mash/cupwarmer/wiki/source-celus-ai-electronics-design.md

---
title: CELUS AI 設計要約
type: source-summary
tags: [celus, ai, schematic, component-search]
sources: [celus-ai-electronics-design.md]
created: 2026-04-11
updated: 2026-04-11
---

[CELUS AI Electronics Design](raw/celus-ai-electronics-design.md) は、CELUS の価値が component search と schematic generation の自動化にあることを示している。

最終 PCB の主戦場というより、前工程を速めて EDA へ handoff する補助ツールとして理解するのが自然である。
