mash/cupwarmer/wiki/source-flux-ai-pcb-design.md

---
title: Flux AI PCB 要約
type: source-summary
tags: [flux, ai, pcb, schematic]
sources: [flux-ai-pcb-design.md]
created: 2026-04-11
updated: 2026-04-11
---

[Flux AI PCB Design](raw/flux-ai-pcb-design.md) は、Flux が AI を設計体験の中心に据えていることを示している。要件整理、部品選定、BOM、回路図変更、datasheet parsing まで AI が直接支援する。

ただし公式ドキュメント自身が、AI は `schematics` 主体で、`PCB layout and trace positioning` の理解は `limited` と述べている。したがって、AI の強さと高密度レイアウトの強さは同義ではない。
