mash/cupwarmer/wiki/source-kicad-pcb-design-features.md

---
title: KiCad PCB 機能要約
type: source-summary
tags: [kicad, pcb, rules, plugins, open-source]
sources: [kicad-pcb-design-features.md, kicad-plugin-and-rules.md]
created: 2026-04-11
updated: 2026-04-11
---

[KiCad PCB Design Features](raw/kicad-pcb-design-features.md) と [KiCad Plugins and Rules](raw/kicad-plugin-and-rules.md) から、KiCad は AI 内蔵 EDA ではないが、`interactive router`、`custom design rules`、`Plugin and Content Manager`、`Action plugins`、`up to 32 copper layers` を持つことが分かる。

つまり KiCad の強みは「生成AIが賢いこと」ではなく、「設計者がルールを握ったまま、拡張しやすい安定した PCB 基盤」である。
