mash/cupwarmer/wiki/source-wpc-qi-specification.md

---
title: WPC Qi Specification 要約
type: source-summary
tags: [qi, wpc, spec, versions]
sources: [wpc-qi-specification.md]
created: 2026-04-11
updated: 2026-04-11
---

[WPC Qi Specification 原文](raw/wpc-qi-specification.md) は、`Qi` 仕様の版の流れを確認するのに有用である。`v1.0` から `v2.0` までの履歴が明記され、2026-04-11 時点の最新仕様は `v2.3` とされている。

この履歴により、`Qi` の版差分を `BPP` 世代の旧設計から `EPP` や `Qi2` まで連続した流れとして把握できる。現行の `15W` 検討では、版名だけでなく対応プロファイルと認証状況も合わせて見る必要がある。

版差分を前提にした実務整理は [Qi Wireless Power](qi-wireless-power.md) にまとめた。
