mash/cupwarmer/wiki/raw/altium-designer-and-ai.md

# Altium Designer and AI Notes

- Source 1: [Altium Designer](https://www.altium.com/altium-designer)
- Source 2: [Altium AI & Machine Learning resources](https://resources.altium.com/ai-design)
- Accessed: 2026-04-11

## Notes

- Altium Designer は `schematics and layout to simulation and analysis` を統合した商用 EDA。
- `Smart Interactive Routing`、`Assistive Layout Technology`、`HDI Design`、`constraint management` を明示している。
- Altium の AI ページは、`built-in machine learning to increase productivity with design flows` と述べるが、Flux のような明確な AI copilot 製品説明ではない。

## Relevance

- AI よりも、HDI / dense layout / 商用ワークフローの強さが本質。
- 予算が許せば `WLCSP` や高密度案件との相性は強い。
