mash/cupwarmer/wiki/raw/celus-ai-electronics-design.md

# CELUS AI Electronics Design

- Source: [CELUS Design Platform for Engineers](https://www.celus.io/solutions/engineers)
- Accessed: 2026-04-11

## Notes

- CELUS は `AI-driven automation` により component search と schematic generation を自動化すると説明している。
- `automates component search and schematic generation` が中心メッセージ。
- `handover to EDA files` を案内しており、自前で最終 PCB を全部抱えるというより前工程自動化寄り。

## Relevance

- 回路の初期案作成には向く。
- 最終 PCB を詰める主戦場というより、前工程を短縮する補助ツールとして見るのが自然。
