mash/cupwarmer/wiki/raw/flux-ai-pcb-design.md

# Flux AI PCB Design

- Source 1: [Flux home](https://www.flux.ai/)
- Source 2: [Flux AI assistant docs](https://www.flux.ai/COPILOT)
- Accessed: 2026-04-11

## Notes

- Flux は `Design PCBs with AI` を掲げるブラウザベース EDA。
- AI は要件整理、部品選定、BOM、回路図生成、設計変更支援を行う。
- ドキュメントでは AI が `schematics` を主に扱い、`PCB layout and trace positioning` の理解は `limited` と明記している。
- AI は datasheet parsing、component search、design feedback、schematic modifications を行える。

## Relevance

- AI 支援の強さは明確。
- ただし今回のような `WLCSP40`、`FOD`、外注 DFM 前提の細かいレイアウト案件では、AI の強みが回路図寄りに偏る。
