mash/cupwarmer/wiki/raw/kicad-pcb-design-features.md

# KiCad PCB Design Features

- Source: [KiCad PCB Design in PcbNew](https://www.kicad.org/discover/pcb-design/)
- Accessed: 2026-04-11

## Notes

- KiCad は回路図と PCB の統合フローを持つ。
- `interactive router` を持つ。
- `DRC with scripting support` を持つ。
- 他 CAD からの import も案内している。
- `length tuning`、`Footprint Editor`、`3D Viewer` がある。

## Relevance

- AI 内蔵 EDA ではないが、個人開発に必要な PCB 基盤機能は十分強い。
- `WLCSP` のような難物でも、ルールを明示して運用する土台として使える。
