mash/cupwarmer/wiki/raw/wpc-qi-specification.md

# WPC Qi Specification Overview

- Source: [Qi Specification (Wireless Power Consortium)](https://www.wirelesspowerconsortium.com/knowledge-base/qi-specification/)
- Accessed: 2026-04-11

## Notes

- WPC は `Qi` 仕様の履歴として、`v1.0` が 2010 年、`v1.1` が 2012 年、`v1.2` が 2015 年、`v1.3` が 2021 年、`v2.0` が 2023 年と示している。
- 最新仕様は `v2.3` と記載されているが、詳細本文のダウンロードは会員向け。
- 自動車向けガイドラインなど派生の設計資料も管理されている。

## Relevance

- プロジェクトが使おうとしている `BQ51013B` の `Qi v1.2` 対応という表現を、仕様の歴史の中で位置づけられる。
