mash/cupwarmer/wiki/fod-foreign-object-detection.md

---
title: Foreign Object Detection
type: concept
tags: [qi, fod, safety, wireless-power, cup-warmer, magnets]
sources: [wpc-qi-v13-power-delivery.md, wpc-qi2-magnetic-alignment.md, infineon-wlc1115-15w-transmitter.md, nxp-mwpr1516-15w-wireless-charging-receiver.md]
created: 2026-04-11
updated: 2026-04-11
---

`FOD` は `Foreign Object Detection` の略で、`Qi` の送受電コイル間に想定外の金属物体などが入ったときに、余計な損失と発熱を検出して危険を抑えるための仕組みである。

## 何を防ぐのか

`Qi` では、受電器そのものではない金属片や構造材が磁界で加熱されうる。問題は「充電効率が落ちる」ことではなく、想定外の場所が熱くなることにある。

特に危険なのは次のようなケースである。

- コインやクリップなどの金属小物
- 金属底のカップやマグ
- コイル近傍の金属プレートやネジ
- 位置ずれや距離増加で損失が増えた構造

## どうやって成立するか

[Infineon WLC1115 要約](source-infineon-wlc1115-15w-transmitter.md) にある通り、現行の送電側は `Q-factor`、共振周波数、電力損失など複数の指標を見て `FOD` を実装する。これは、想定した受電条件から外れた損失が増えたときに、どこかで余計な発熱が起きているとみなす考え方である。

[NXP MWPR1516 要約](source-nxp-mwpr1516-15w-wireless-charging-receiver.md) のように、受電側も `FOD` アルゴリズムを持つものがある。したがって `FOD` は送電側だけの話ではなく、送受電系全体の損失挙動をどう扱うかという設計課題である。

## Cup Warmer で難しくなる理由

Cup Warmer は、`Qi` 本来のスマートフォン充電よりも `FOD` を難しくしやすい。

理由は、コイルの上に置くもの自体が熱設計対象であり、さらにヒーター、トッププレート、断熱材、フェライトなどの積層でコイル間距離と損失が増えやすいためである。[WPC Qi v1.3 Power Delivery 要約](source-wpc-qi-v13-power-delivery.md) が示すように、受電側はコイル、共振、シールドの構成に強く依存するので、積層変更は単なるメカ設計変更ではない。

Cup Warmer 文脈では、次が `FOD` 誤検出や停止の要因になりやすい。

- 金属カップ底面
- 金属トッププレート
- ヒーター材による追加損失
- コイル中心からの位置ずれ
- コイル間距離の増加
- フェライトやシールドの不足

## 非金属カップ前提なら何が残るか

金属カップを対象外にすると、`FOD` の難所は「ユーザーのカップ材質」より「自分で作る積層構造」に寄る。優先度が高いのは次である。

- 金属トッププレートや化粧層の混入
- ヒーター材による余計な損失
- コイル間距離の増加
- 送電パッドと受電コイルの位置ずれ
- フェライト不足や磁束漏れ
- 送電パッドごとの `FOD` 閾値差

逆に、金属カップ底が異物扱いされる問題は、この前提では主要課題から外せる。

## 設計上の含意

`FOD` は後付けの安全機能ではなく、送受電アーキテクチャの一部として扱うべきである。Cup Warmer では少なくとも次を早期に評価する必要がある。

- どの送電パッドで安定給電するか
- どの位置ずれ条件で停止するか
- 金属マグや金属部材がどこで異物扱いになるか
- 温度上昇と `FOD` 停止がどう対応するか

言い換えると、「発熱したか」だけでは不十分で、「安全に継続給電できる構造か」を見る必要がある。

## 非金属カップ前提の評価表

| 項目 | 何を見るか | 主な失敗モード | 優先度 |
|---|---|---|---|
| 受電コイル単体 | ベースライン給電の安定性 | そもそも規定電力に届かない | 高 |
| フェライト追加 | 効率と停止耐性の改善 | 磁束漏れで損失が大きい | 高 |
| ヒーター積層 | ヒーター材の追加損失 | `FOD` 停止、局所発熱 | 高 |
| トッププレート積層 | 表面材の影響 | 金属層で損失増、温度上昇 | 高 |
| 位置ずれ | 許容オフセット量 | 特定位置で停止、出力低下 | 高 |
| パッド差 | 送電側ごとの相性 | あるパッドだけ停止する | 中 |
| 長時間運転 | 温度と停止の再現性 | 徐々に加熱されて後から停止 | 中 |

## 位置ずれ対策として磁石は使えるか

使える。ただし「何を位置合わせしたいか」を分けて考える必要がある。

[WPC Qi2 Magnetic Alignment 要約](source-wpc-qi2-magnetic-alignment.md) が示す通り、`Qi2` は磁気位置合わせを公式に採用している。したがって、磁石を使うこと自体が `Qi` 系ワイヤレス給電と矛盾するわけではない。

一方で、このプロジェクトは現時点で `Qi2` 準拠品ではない。したがって磁石は「標準機能の利用」ではなく、独自の位置ずれ補助手段として評価すべきである。

実務上は、次の 2 つを分けるべきである。

- 送電パッドと受電コイルの中心合わせを補助する磁石
- カップそのものの置き位置を決めるための磁石

前者は `FOD` と効率の改善に効く可能性がある。後者は、陶器カップ前提なら直接は固定できず、磁性体追加や別部材が必要になるので設計上の見返りが小さい。

## 磁石を使う場合の注意点

- 磁石は受電コイルの中心合わせ補助として使う
- コイル直下や磁束経路を乱す位置に安易に置かない
- 磁石だけでなく、保持用の金属リングやヨーク材の影響も評価する
- `Qi2` の磁石配置をそのまま流用するのではなく、独自構造として停止条件を確認する
- 磁石追加後は、効率、位置ずれ耐性、温度上昇、`FOD` 停止条件を再測定する

## このプロジェクトでの実務的な読み替え

- `Qi` 受電部は単なる無線 `5V` 電源ではない
- 熱源、天板、固定部材の材質選定は `FOD` に直結する
- 金属カップ対応を目指すなら、かなり早い段階で実機評価が必要になる
- パッド互換性は出力ワット数だけでなく `FOD` の閾値差にも左右される

## 関連ページ

- [Qi Wireless Power](qi-wireless-power.md)
- [Qi 15W Receiver Options](qi-15w-receiver-options.md)
- [Infineon WLC1115 要約](source-infineon-wlc1115-15w-transmitter.md)
- [NXP MWPR1516 要約](source-nxp-mwpr1516-15w-wireless-charging-receiver.md)
- [WPC Qi2 Magnetic Alignment 要約](source-wpc-qi2-magnetic-alignment.md)
