mash/cupwarmer/wiki/source-littelfuse-polyswitch-resettable-pptc-devices.md

---
title: Littelfuse PolySwitch PPTC 要約
type: source-summary
tags: [pptc, ptc, fuse, protection, resettable]
sources: [littelfuse-polyswitch-resettable-pptc-devices.md]
created: 2026-04-11
updated: 2026-04-11
---

[Littelfuse PolySwitch 原文](raw/littelfuse-polyswitch-resettable-pptc-devices.md) は、`PPTC` を自動復帰型の過電流保護部品として整理している。温度上昇で抵抗が増え、異常電流を制限し、冷えると元に戻る。

この説明は、セラミック `PTC` 一般論よりも「保護デバイス」としての `PTC` を理解するのに向いている。通常のヒューズと違い交換不要で、反復的な故障やアクセスしにくい機器に向くという整理も重要。

Cup Warmer の `PTC ヒューズ` という表現は、厳密にはこの `PPTC` 系の考え方に近い。したがって [PTC Thermistor](ptc-thermistor.md) では、セラミック `PTC` とポリマー `PPTC` を分けて扱う必要がある。
