mash/cupwarmer/wiki/source-renesas-p9221-r-15w-wireless-power-receiver.md

---
title: Renesas P9221-R 要約
type: source-summary
tags: [qi, epp, 15w, receiver, renesas, obsolete]
sources: [renesas-p9221-r-15w-wireless-power-receiver.md]
created: 2026-04-11
updated: 2026-04-11
---

[Renesas P9221-R 原文](raw/renesas-p9221-r-15w-wireless-power-receiver.md) は、`15W` 受電器としては魅力的な仕様を持つ一方で、2026-04-11 時点では `Obsolete` であることを明確にしている。

そのため、このページは「技術的には参考になるが、新規設計の第一候補にはしにくい」という位置づけになる。

判断の落とし込みは [Qi 15W Receiver Options](qi-15w-receiver-options.md) にまとめた。
