mash/cupwarmer/wiki/source-renesas-p9415-r-evk-15w-rx-eval-board.md

---
title: Renesas P9415-R-EVK 要約
type: source-summary
tags: [qi, 15w, epp, receiver, eval-board, renesas, obsolete]
sources: [renesas-p9415-r-evk-15w-rx-eval-board.md]
created: 2026-04-11
updated: 2026-04-11
---

[Renesas P9415-R-EVK 原文](raw/renesas-p9415-r-evk-15w-rx-eval-board.md) は、`15W EPP` 受電の turnkey reference design としては充実しているが、2026-04-11 時点では `Obsolete` である。

そのため、設計学習や比較資料としては有効だが、新規製品の採用候補としては弱い。
