mash/cupwarmer/wiki/source-st-steval-isb042v1-15w-rx-eval-board.md

---
title: ST STEVAL-ISB042V1 要約
type: source-summary
tags: [qi, 15w, epp, receiver, eval-board, st]
sources: [st-steval-isb042v1-15w-rx-eval-board.md]
created: 2026-04-11
updated: 2026-04-11
---

[ST STEVAL-ISB042V1 原文](raw/st-steval-isb042v1-15w-rx-eval-board.md) は、`STWLC33` ベースで `15W EPP` と `5W BPP` の両方を扱える受電評価ボードを示している。`FOD` と `I2C` を持つ complete kit だが、2026-04-11 時点では `Out of Production` である。

したがって、量産本命ではなく「`15W` と `FOD` を先に触るための古い参照設計」として見るのが適切である。
