mash/cupwarmer/wiki/source-st-steval-wlc38rx-receiver-board-press-release.md

---
title: ST STEVAL-WLC38RX 要約
type: source-summary
tags: [qi, 15w, receiver, eval-board, st, stwlc38]
sources: [st-steval-wlc38rx-receiver-board-press-release.md]
created: 2026-04-11
updated: 2026-04-11
---

[ST STEVAL-WLC38RX 原文](raw/st-steval-wlc38rx-receiver-board-press-release.md) は、`STWLC38` ベースの `5W/15W` 受電評価ボードが、試作と試験を加速する目的で提供されていることを示す。Mouser 掲載の data brief ベースでは、`Qi 1.3`、`5W BPP` / `15W EPP`、`I2C` 設定、オンボード `USB-to-I2C bridge`、`STSW-WPSTUDIO` GUI、`ARC`、`FOD` 用の電圧 / 電流測定、on-chip thermal management まで確認できる。

Cup Warmer 文脈では、`WLCSP40` の直接実装を避けつつ、`15W` の熱・`FOD`・位置ずれ評価に入れる点が重要である。特に USB-I2C と GUI があるため、初期 bring-up と設定確認を IC 単体実装よりかなり楽に始められる。
