mash/cupwarmer/wiki/source-wpc-qi-certified-products.md

---
title: WPC Qi Certified Products 要約
type: source-summary
tags: [qi, certification, interoperability, safety]
sources: [wpc-qi-certified-products.md]
created: 2026-04-11
updated: 2026-04-11
---

[WPC Qi Certified Products 原文](raw/wpc-qi-certified-products.md) は、`Qi Certified` の意味を明確にしている。認証済み製品は独立試験で安全性、相互運用性、エネルギー効率を確認されている一方、`Qi compatible` のような表現は正式認証を示さない。

この点はプロトタイピングで重要で、市販パッドを使うときは「給電できたか」だけでなく「認証済みか」を分けて記録すべきだと分かる。

実務的な含意は [Qi Wireless Power](qi-wireless-power.md) と [Foreign Object Detection](fod-foreign-object-detection.md) に接続する。
