mash/cupwarmer/wiki/source-wpc-qi-wireless-charging.md

---
title: WPC Qi Wireless Charging 要約
type: source-summary
tags: [qi, wpc, certification, overview]
sources: [wpc-qi-wireless-charging.md]
created: 2026-04-11
updated: 2026-04-11
---

[WPC Qi Wireless Charging 原文](raw/wpc-qi-wireless-charging.md) は、`Qi` を携帯機器向けワイヤレス充電の中心標準として位置づけている。2026-04-11 時点では、2010 年開始、`13,000` 超の認証製品、`Qi2 25W` の登場までが概観できる。

このページの重要点は、`Qi` を単なる電力伝送方式ではなく、安全性と相互運用性を含む認証体系として扱っていることにある。よって「Qi 対応」と「Qi 認証」は同義ではない。

一般概念の整理は [Qi Wireless Power](qi-wireless-power.md) に反映した。
