mash/cupwarmer/wiki/source-wpc-qi2-magnetic-alignment.md

---
title: WPC Qi2 Magnetic Alignment 要約
type: source-summary
tags: [qi, qi2, magnets, alignment, wpc]
sources: [wpc-qi2-magnetic-alignment.md]
created: 2026-04-11
updated: 2026-04-11
---

[WPC Qi2 Magnetic Alignment 原文](raw/wpc-qi2-magnetic-alignment.md) は、`Qi2` が magnetic attachment technology を使って位置合わせと効率改善を図ることを示している。

このソースから分かるのは、磁石が `Qi` 系ワイヤレス給電で本質的に禁止されているわけではなく、むしろ位置合わせの改善手段として公式に採用されているという点である。ただし、Cup Warmer でそのまま `Qi2` 準拠になるわけではないので、独自構造として別途評価は必要である。
