mash/cupwarmer/wiki/raw/infineon-wlc1115-15w-transmitter.md

# Infineon WLC1115 15W Transmitter

- Source: [WLC1115-68LQXQ - Wireless charging ICs | Infineon Technologies](https://www.infineon.com/part/WLC1115-68LQXQ)
- Accessed: 2026-04-11

## Notes

- `WLC1115` は `Active and preferred` の `15W` transmitter。
- `Supports MPP, EPP, BPP protocols`。
- `Foreign Object Detection (FOD)` は `Q-factor`, `resonant frequency`, `power loss methods` を使う。
- `I2C`, `UART` を持つ。
- `Qi1.3, Qi2.x` をサポートする送電側ソリューション。

## Relevance

- 受電候補ではないが、2026-04-11 時点の `15W` 送電側エコシステムが `EPP/BPP` を含むことの参考になる。
- Cup Warmer の評価用送電パッドの考え方を整理するのに有用。
