mash/cupwarmer/wiki/raw/kicad-plugin-and-rules.md

# KiCad Plugins and Rules

- Source 1: [KiCad documentation](https://docs.kicad.org/7.0/en/kicad/kicad.html)
- Source 2: [KiCad PCB editor documentation](https://docs.kicad.org/7.0/en/pcbnew/pcbnew.html)
- Source 3: [KiCad master PCB editor docs - action plugins](https://docs.kicad.org/master/ko/pcbnew/pcbnew.html)
- Accessed: 2026-04-11

## Notes

- KiCad は `Plugin and Content Manager` を持つ。
- PCB は `up to 32 copper layers` を扱える。
- `Custom design rules` を持つ。
- `Action plugins` によりスクリプト拡張できる。

## Relevance

- AI は内蔵しないが、外部ツールや自動化を噛ませやすい。
- `WLCSP` / `via-in-pad` / 局所ルールの管理に向く。
