mash/cupwarmer/wiki/raw/littelfuse-polyswitch-resettable-pptc-devices.md

# Littelfuse PolySwitch Resettable PPTC Devices

- Source: [PolySwitch Resettable PPTC Devices (Littelfuse)](https://www.littelfuse.com/products/fuses-overcurrent-protection/polyswitch-resettable-pptc-devices)
- Accessed: 2026-04-11

## Notes

- Littelfuse は PPTC を `Polymeric Positive Temperature Coefficient` デバイス、すなわちリセッタブルな過電流保護素子として説明している。
- 電流や自己発熱で温度が上がると抵抗が上昇し、危険な電流を制限する。
- 故障条件がなくなり温度が安全域に戻ると、抵抗は自動的に低い状態へ戻る。
- 一般的な一次性ヒューズとの違いとして、自動復帰できる点と、反復的な過電流イベントや保守性重視の用途に向く点が挙げられている。

## Relevance

- Cup Warmer 文脈では、温度異常や短絡が起きたときに完全な制御ロジックへ依存せず電流を絞る保護部品として意味がある。
- ただし PPTC は「精密な温度制御」ではなく「異常時の電流制限」が主目的。
