mash/cupwarmer/wiki/raw/nxp-mwpr1516-15w-wireless-charging-receiver.md

# NXP MWPR1516 15W Wireless Charging Receiver

- Source: [15 Watt Wireless Charging Receiver ICs | NXP Semiconductors](https://www.nxp.com/products/power-management/wireless-power/15-watt-wireless-charging-receiver-ics%3AMWPR1516)
- Accessed: 2026-04-11

## Notes

- `MWPR1516` は `Active`。
- `up to 15 watt charging power`。
- `Arm Cortex-M0+` ベース。
- `Optimized Foreign Object Detection algorithm`。
- `I2C and UART`。
- `WPC` と `MPWG` 仕様に準拠すると説明されている。
- 公開資料一覧には `Data Sheet`、`Fact Sheet`、`Reference Manual`、`Reference Design User's Guide` がある。
- ドキュメント日付は比較的古く、データシートは `2014-01-09 Rev 2`、ファクトシートは `2020-02-12 Rev 1`、参照設計の User Guide は `2016-09-21 Rev 0`。

## Relevance

- `15W` と `Arm Cortex-M0+`、`FOD`、通信機能を備える受電候補。
- 情報の鮮度には不安があるが、Active かつ参照設計群を持つ点は強い。
