mash/cupwarmer/wiki/raw/nxp-mwpr1516-package-quality.md

# NXP MWPR1516 Package / Quality

- Source: [MWPR1516 Package / Quality | NXP Semiconductors](https://www.nxp.com/products/power-management/wireless-power/15-watt-wireless-charging-receiver-ics%3AMWPR1516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)
- Accessed: 2026-04-11

## Notes

- `MWPR1516CFM` は `HUQFN32`、`Active`。
- `MWPR1516CAL` は `WLCSP36`、`Active`。
- `MWPR1516CFM` の `MSL` は `3`。
- `MWPR1516CAL` の `MSL` は `1`。

## Relevance

- `WLCSP` を避けたい条件に対して、`HUQFN32` 版が公式に存在することが重要。
- Cup Warmer では、この一点で `STWLC38JRM` より扱いやすい可能性が高い。
