mash/cupwarmer/wiki/raw/renesas-p9221-r-15w-wireless-power-receiver.md

# Renesas P9221-R 15W Wireless Power Receiver

- Source: [P9221-R - WPC 1.2.2 Compliant, Wireless Charging Receiver for 15W Applications | Renesas](https://www.renesas.com/en/products/p9221-r)
- Accessed: 2026-04-11

## Notes

- `P9221-R` は `Obsolete`。
- `Single-chip, 15W, wireless power receiver`。
- `WPC 1.2.2 compliant`。
- `Embedded 32bit ARM Cortex-M0 processor`。
- `Supports I2C interface`。
- `9V or 12V DC output voltage`。
- `52-WLCSP` パッケージ。

## Relevance

- 仕様だけ見れば Cup Warmer に必要な `15W` 受電能力に届く。
- ただし新規設計候補としては採りにくい。
