mash/cupwarmer/wiki/raw/st-steval-isb042v1-15w-rx-eval-board.md

# ST STEVAL-ISB042V1 15W Receiver Evaluation Board

- Source: [STEVAL-ISB042V1 | Product - STMicroelectronics](https://www.st.com/en/evaluation-tools/steval-isb042v1.html)
- Accessed: 2026-04-11

## Notes

- `STEVAL-ISB042V1` は `15-watt Qi` receiver evaluation board。
- `STWLC33` ベース。
- `Extended Power Profile Qi v1.2` に準拠し、`up to 15 W / 10 V maximum output power`。
- `5W/5V` の `BPP` 後方互換あり。
- `FOD` と `I2C interface` を持つ。
- `Out of Production`。

## Relevance

- IC 単体のパッケージ難を避けて `15W` をまず評価するなら有力な参照設計。
- ただし現時点では新規採用の長期軸には置きにくい。
