mash/cupwarmer/wiki/raw/st-stwlc38jrm-15w-wireless-power-receiver.md

# ST STWLC38JRM 15W Wireless Power Receiver

- Source: [STWLC38JRM | Product - STMicroelectronics](https://www.st.com/en/power-management/stwlc38jrm.html)
- Accessed: 2026-04-11

## Notes

- `STWLC38JRM` は `Active` かつ `volume production` の `15W Wireless Power Receiver`。
- `Up to 15 W output power`。
- `4 V to 12 V programmable output voltage`。
- `32-bit, 64 MHz Arm Cortex-M0+ core` を内蔵。
- `I2C target interface for host controller` を持つ。
- `Accurate current sense system for Foreign Object Detection (FOD)` を持つ。
- `RRAM` により `I2C` 経由のカスタマイズと proprietary communication / charging protocols をサポートする。

## Relevance

- 2026-04-11 時点で、公式情報上かなり素直に使える `15W` 受電候補。
- ただしパッケージは `WLCSP40` で実装難度は低くない。
