mash/cupwarmer/wiki/raw/st-stwlc38jrm-data-brief-db5568.md

# ST STWLC38JRM Data Brief DB5568

- Source: Local PDF asset `wiki/raw/assets/stwlc38jrm.pdf`
- Original file: `/Users/mash/Downloads/stwlc38jrm.pdf`
- Accessed: 2026-04-11

## Notes

- 文書は `DB5568 - Rev 1.0 - June 2025` の data brief。
- タイトルは `15W Wireless Power Receiver`。
- `Up to 15 W output power`。
- `4 V to 12 V programmable output voltage`。
- `32-bit, 64 MHz Arm Cortex M0+ core`。
- `I2C target interface for host controller`。
- `Overcurrent and thermal protections`。
- `Overvoltage clamping protection`。
- `Accurate current sense system for Foreign Object Detection (FOD)`。
- `WLCSP40 5 x 8 Ball`、寸法 `2.12 mm x 3.32 mm x 0.56 mm`、ピッチ `0.4 mm`。
- `embedded RRAM nonvolatile memory` により `I2C` 経由の customization と proprietary communication / charging protocols をサポート。
- `Additional firmware patching` により application flexibility を改善するとある。

## Relevance

- 既存の製品ページ情報に対して、`overcurrent`、`thermal protection`、`overvoltage clamping`、`firmware patching` まで明示された。
- `15W`、`programmable output`、`FOD`、`I2C`、`RRAM` が公式 PDF で再確認できた。
