mash/cupwarmer/wiki/raw/tdk-ntc-thermistors-general-technical-information.md

# TDK NTC Thermistors - General Technical Information

- Source: [NTC Thermistors - General technical information (TDK Electronics)](https://www.tdk-electronics.tdk.com/download/188302/19643b7ea798d7c4670141a88cd993f9/pdf-general-technical-information.pdf)
- Accessed: 2026-04-11

## Notes

- IEC 60539 に基づき、NTC は温度上昇で抵抗が下がる温度感応型半導体抵抗体。
- 抵抗温度係数はおおむね `-2%/K` から `-6%/K`。
- 周囲温度変化だけでなく、通電による自己発熱でも抵抗値が変わる。
- 材料はマンガン、ニッケル、コバルト、銅、亜鉛などを含む混合酸化物セラミクス。
- 実用用途は温度依存の抵抗変化を利用する計測、補償、制御。

## Relevance

- 温度を連続的に読みたい用途に向く。
- Cup Warmer では天板裏面温度を監視するセンサ候補として自然。
