mash/cupwarmer/wiki/raw/tdk-ptc-thermistors-general-technical-information.md

# TDK PTC Thermistors - General Technical Information

- Source: [PTC Thermistors - General technical information (TDK Electronics)](https://www.tdk-electronics.tdk.com/download/531162/d78540dfe0589d2bd90cabef477c90b9/pdf-general-technical-information.pdf)
- Accessed: 2026-04-11

## Notes

- PTC サーミスタは、ある温度を超えると抵抗が急増するセラミック部品。
- 文書では、過電流に対するリセッタブルヒューズ、モーター短絡保護、遅延スイッチング、自己調温ヒーターなどへの用途を挙げている。
- キー概念は強誘電体のキュリー温度で、この付近を超えると抵抗が指数関数的に増加する。
- 一定範囲では温度上昇に対して抵抗が急増し、その後の高温域では再び負特性を示す領域もある。

## Relevance

- 「一定温度を超えたら電流を通しにくくする」保護動作に向く。
- Cup Warmer では、制御系と独立した過温保護の考え方と相性がよい。
