mash/cupwarmer/wiki/raw/wpc-qi-certified-products.md

# WPC Qi Certified Products

- Source: [Qi Certified Products (Wireless Power Consortium)](https://www.wirelesspowerconsortium.com/knowledge-base/testing-and-certification/qi-certified-products/)
- Accessed: 2026-04-11

## Notes

- `Qi Certified` 製品は安全性、相互運用性、エネルギー効率の独立試験を通過した製品と説明されている。
- `Qi compliant` や `Works with Qi` のような表現は、正式認証を経ていない可能性があると警告している。
- 認証済みの送電側と受電側はメーカーが異なっても動作することが、`Qi` の価値として明記されている。

## Relevance

- プロトタイプ評価で、市販パッドの「Qi 対応」表記と「Qi 認証」表記を区別すべき理由になる。
