mash/cupwarmer/wiki/raw/wpc-qi-wireless-charging.md

# WPC Qi Wireless Charging

- Source: [Qi Wireless charging (Wireless Power Consortium)](https://www.wirelesspowerconsortium.com/standards/qi-wireless-charging/)
- Accessed: 2026-04-11

## Notes

- WPC は `Qi` をスマートフォンなどの携帯機器向けワイヤレス充電標準として説明している。
- ページでは `Qi` が 2010 年に始まり、2026-04-11 時点で `13,000` を超える認証製品があるとしている。
- `Qi v2.0` は 2023 年、`Qi v2.2.1` は 2025 年 7 月に `Qi2 25W` として登場したとある。
- 認証済み製品のみが Qi / Qi2 ロゴを表示でき、安全性と相互運用性の保証になるとされる。

## Relevance

- `Qi` が単なる実装方式ではなく、認証と相互運用を含む標準であることの根拠になる。
