mash/cupwarmer/wiki/raw/wpc-qi2-magnetic-alignment.md

# WPC Qi2 Magnetic Alignment

- Source: [Qi Wireless charging (Wireless Power Consortium)](https://www.wirelesspowerconsortium.com/standards/qi-wireless-charging/)
- Accessed: 2026-04-11

## Notes

- `Qi2` devices feature magnetic attachment technology と説明されており、機器と充電器を正しく位置合わせすることで、効率、充電速度、使いやすさを改善するとされる。
- `Qi2 25W` でも magnetic locking support が言及されている。
- これは磁石がワイヤレス給電系で禁物という意味ではなく、位置合わせを助ける仕組みとして標準化された用途があることを示す。

## Relevance

- Cup Warmer で位置ずれ対策に磁石を使えるかを考えるときの、`WPC` 公式側の最小根拠になる。
