mash/cupwarmer/wiki/source-altium-designer-and-ai.md

---
title: Altium Designer と AI 要約
type: source-summary
tags: [altium, hdi, pcb, ai]
sources: [altium-designer-and-ai.md]
created: 2026-04-11
updated: 2026-04-11
---

[Altium Designer and AI Notes](raw/altium-designer-and-ai.md) から、Altium の本質は `Smart Interactive Routing`、`Assistive Layout Technology`、`HDI Design`、`constraint management` にあることが分かる。

AI については Altium 自身が `built-in machine learning` を述べるが、Flux のような AI 主役の設計体験を前面に出しているわけではない。したがって、Altium は「AI EDA」というより「強い商用 EDA」として評価すべきである。
