mash/cupwarmer/wiki/source-infineon-wlc1115-15w-transmitter.md

---
title: Infineon WLC1115 要約
type: source-summary
tags: [qi, 15w, transmitter, infineon, epp, bpp]
sources: [infineon-wlc1115-15w-transmitter.md]
created: 2026-04-11
updated: 2026-04-11
---

[Infineon WLC1115 原文](raw/infineon-wlc1115-15w-transmitter.md) は、2026-04-11 時点の現行 `15W` 送電側が `EPP` と `BPP` を併せ持ち、`FOD` も複数方式で実装していることを示す。

受電候補そのものではないが、Cup Warmer の評価対象を `EPP 15W` パッド中心に置く理由の補強になる。

受電候補との関係は [Qi 15W Receiver Options](qi-15w-receiver-options.md) に接続する。
