mash/cupwarmer/wiki/source-st-tn1200-flip-chip-recommendations.md

---
title: ST TN1200 Flip-Chip 要約
type: source-summary
tags: [st, flip-chip, wlcsp, assembly, manufacturing]
sources: [st-tn1200-flip-chip-recommendations.md]
created: 2026-04-11
updated: 2026-04-11
---

[ST TN1200 原文](raw/st-tn1200-flip-chip-recommendations.md) は、ST の micro-bump flip-chip を通常の SMD と同様に扱えると説明している。特に、追加工程や `underfill` が必須ではないこと、既存の pick-and-place で載せられることは重要である。

一方で、リワークやハンドリングには注意が必要で、`mini-stencil` を優先し、バンプ面へ圧力をかける扱いは避けるべきとしている。
