mash/cupwarmer/hardware/kicad/heater/heater-preview.png

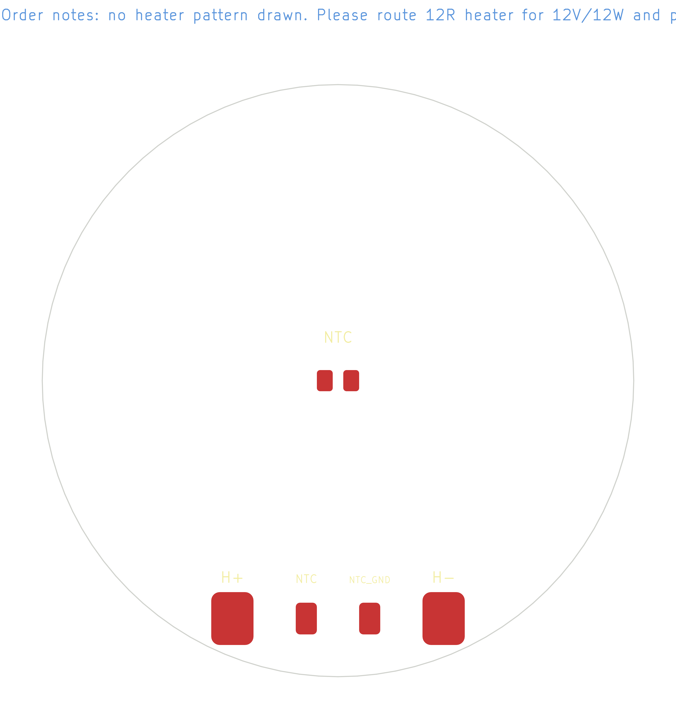
hardware/kicad/heater/heater-preview.png
