mash/cupwarmer/hardware/bom/bom.csv

ref | category | part | manufacturer | mpn | lcsc | status | supplier_url | notes
U1 | Qi receiver IC | 15W wireless power receiver | STMicroelectronics | STWLC38JRM | C5267845 | selected |  | WLCSP40 0.4mm pitch outsourced assembly; JLC stock low (~4) — verify before order
L1 | receiver coil | 8uH Qi RX coil | Wuerth Elektronik | 760308102207 |  | selected | https://www.digikey.com/en/products/detail/w%C3%BCrth-elektronik/760308102207/5050819 | WE-WPCC 8uH +/-10% @125kHz, 40x40x1.2mm rounded-square Qi RX coil with back adhesive tape/release paper per Wuerth DS; DS does not explicitly specify an integrated ferrite shield, while RS lists ferrite core / rear EMI shield at series-page level — verify received construction before deleting SHIELD1; DCR=60mΩ typ (80mΩ max), Q=30 typ @125kHz, IR=5A (ΔT=40K), fres=16MHz; AN5961 Table 1 L4 reference part; solder-pad termination, 2 holes φ1.2mm at 5.0mm pitch; not on JLC — source from Mouser/Digi-Key, hand-mount post-PCBA; rounded corners (Rc≈5–8mm visible in DS) fit within φ56mm PCB outline; alternate/measurement-comparison candidate: CND-tek YX-A11-R351125-G0265 (LCSC C49297385, currently absent from local JLC DB)
SHIELD1 | ferrite sheet | 60x60x0.5mm flexible sintered ferrite sheet | Wuerth Elektronik | 364105 |  | selected | https://www.digikey.com/en/products/detail/w%C3%BCrth-elektronik/364105/10106966 | WE-FSFS flexible sintered ferrite sheet with adhesive; mechanical part, no JLC SMT placement; source separately from Wuerth distributor and trim/fixture to coil backing envelope; use as v1 separate backing ferrite candidate if L1's integrated ferrite is not sufficient; remeasure coil L/Q/DCR and FOD/position-offset behavior after assembly
C1,C16,C17 | resonant capacitor | 100nF 50V C0G | Murata | GRM31C5C1H104JA01L | C97946 | selected |  | Cs primary 3x parallel resonant caps; DS14078 section 10.4 requires high-Q/high-RMS-current/stable-capacitance resonant MLCCs; 100nF 50V C0G +/-5% 1206 keeps capacitance stable under heater/coil temperature and shares RMS current across three parts; combined with C18/C19 (10nF NP0) gives Cs=320nF for 99.5kHz resonance with 8uH L1; verify cap temperature and VRECT behavior during bring-up
C18,C19 | resonant capacitor | 10nF 50V C0G | Murata | GRM1885C1H103JA01D | C85973 | selected |  | Cs tuning caps; DS14078 section 10.4 high-Q/stable-capacitance requirement; 10nF 50V C0G +/-5% 0603 pairs with C1/C16/C17 (3x100nF C0G) for total Cs=320nF targeting 100kHz Qi resonance with 8uH coil; unified with C11/C13 for BOM simplicity and stronger JLC stock; verify RMS heating in bring-up
C2 | output bulk | 10uF/35V X5R | Murata | GRM188R6YA106MA73D | C194427 | selected |  | VOUT bulk decoupling; matches STEVAL-WLC38RX (CRECT/COUT family); 10uF 35V X5R 0603
Z1 | AC ESD TVS | unidirectional TVS diode 13V | Shandong Jingdao | SMF13A | C353315 | selected |  | AC1 individual ESD/overvoltage clamp to SYS_GND; keep one TVS per AC input per DS14078/UM3154; SOD-123FL VRWM=13V VBR=14.4-15.9V VC=21.5V@9.3A IR<=1uA@VRWM; verify high-temperature leakage and in-band AC swing margin during bring-up
Z2 | AC ESD TVS | unidirectional TVS diode 13V | Shandong Jingdao | SMF13A | C353315 | selected |  | AC2 individual ESD/overvoltage clamp to SYS_GND; keep one TVS per AC input per DS14078/UM3154; SOD-123FL VRWM=13V VBR=14.4-15.9V VC=21.5V@9.3A IR<=1uA@VRWM; verify high-temperature leakage and in-band AC swing margin during bring-up
Z3 | VOUT TVS | unidirectional TVS diode SMB 15V | Littelfuse | SMBJ15A | C83846 | selected |  | VOUT_12V transient clamp to SYS_GND; VR=15V VBR=16.7-18.5V VC=24.4V@24.6A; 600W 10/1000us
C4 | VDD bypass | 100nF 50V X7R | Wuerth Elektronik | 885012206095 | C6715111 | selected |  | VDD HF bypass close to U1; matches STEVAL-WLC38RX (100nF family); 100nF 50V X7R 0603
Q1 | heater switch | N-MOSFET 30V 5.8A SOT-23 | Shenzhen Hottech Electronics | AO3400 | C181090 | selected |  | Rds(on)<=28mOhm@10V; SOT-23 pinout 1=G 2=S 3=D; gate driven from VOUT 12V
D3 | heater flyback diode | Schottky 40V 1A SOD-123 | MDD | B5819W | C8598 | selected |  | Heater flyback / freewheel: anode=HEATER_OUT (Q1.drain), cathode=VOUT_12V; clamps inductive flyback from heater harness when Q1 turns off, returning current to VOUT bulk; SOD-123 Vf<=0.6V@1A, IR<=10uA@VR, reverse-bias during normal ON state
R1 | gate divider top | 12k resistor | UNI-ROYAL | 0603WAF1202T5E | C22790 | selected |  | VOUT_12V -> Q1.G; with R2 forms 12k/10k divider for VGS~=5.45V at VOUT=12V and ~=11.09V at SMBJ15A VC=24.4V
R2 | gate divider bottom | 10k resistor | UNI-ROYAL | 0603WAF1002T5E | C25804 | selected |  | Q1.G -> SYS_GND; with R1 forms 12k/10k divider for VGS~=5.45V at VOUT=12V and ~=11.09V at SMBJ15A VC=24.4V
R3 | current sense resistor | 0.05R 1W current sense resistor | FOJAN | FRM121WFR050TM | C7467249 | selected |  | bring-up build: fit 0.05R 1206 shunt so R3 voltage can be measured for heater current; normal production build may substitute 0R 1206 jumper C17888 / 1206W4F0000T5E
R4 | IEXT clamp resistor | 200R 0805 surge resistor | PANASONIC | ERJP06F2000V | C543538 | selected |  | IEXT SOVP clamp path resistor to VRECT; use R4 || R14 = 100Ω effective per ST reference; 200Ω 0805 500mW ±1% extended; SOVP pulse only, not continuous dissipation: at VRECT=14/17/20/29.2V the pair sinks 140/170/200/292mA and dissipates 1.96/2.89/4.00/8.53W total, half per resistor; IEXT 300mA limit corresponds to 30V across 100Ω; verify SOVP duty, resistor temperature, and VRECT clamp waveform during bring-up
R14 | IEXT clamp resistor | 200R 0805 surge resistor | PANASONIC | ERJP06F2000V | C543538 | selected |  | IEXT SOVP clamp path resistor to VRECT; parallel with R4 for current and pulse-energy sharing; 200Ω 0805 500mW ±1% extended; SOVP pulse only, not continuous dissipation: at VRECT=14/17/20/29.2V the pair sinks 140/170/200/292mA and dissipates 1.96/2.89/4.00/8.53W total, half per resistor; IEXT 300mA limit corresponds to 30V across 100Ω; verify SOVP duty, resistor temperature, and VRECT clamp waveform during bring-up
F1 | thermal cutoff | leaded bimetal thermostat 70C NC | Xucheng Elec | KSD9700-70/5JSB/080C | C156512 | selected |  | independent 12V heater hard cutoff; reverted to leaded bimetal thermostat after JLCPCB rejected SMD candidates NR72CB0 (C183007) and SA77SB0 (C143808) as laser-weld-only (datasheets forbid soldering); trip 70+/-5C reset 50+/-10C NC auto-reset; AC250V/5A, DC12V/12A rating fully covers 12V/~1A heater; dia 8.9 x 28mm metal can with 80mm tinned wire leads, wire-solderable; CQC08002022252 / UL E251340-class / TUV; mount on heater assembly bonded to heater hotspot in series with H+ lead, not on PCB; bulky body needs enclosure clearance rework (old f1_clearance_gap 1.4mm no longer valid)
TH2 | heater NTC | 100k NTC thermistor | Murata Electronics | NCP18WF104F12RB | C71280 | selected | https://flexheater.jlcpcb.com/quote | off-board heater temperature NTC; keep in BOM but not JLC SMT placement; order same MPN together with the custom silicone heater; 100kΩ 0603 NTC B25/85=4260K ±1%; connects through J2 pins 2/3 to RX_NTC/SYS_GND
J2 | heater harness solder pads | 4-wire silicone heater harness pads | N/A | N/A |  | board-feature |  | v1 uses large solder pads / wire pads for external 12 ohm silicone heater (target 12W @ 12V, 1A) plus TH2 heater NTC; pinout pin1 H+, pin2 NTC, pin3 NTC_GND, pin4 H-; 5.0mm pitch; power pads drill 1.4mm, NTC pads drill 1.0mm; no board connector; PCB feature only (PCB ref J2, footprint SolderWire-HeaterHarness_1x04_P5.0mm_D1.4mm; not JLC-assembled, hand-soldered post-PCBA)
J1 | service header | I2C service header 1x4 2.54mm | Boom Precision | PZ254V-11-04P | C2691448 | selected |  | bring-up and configuration access; 1x4 2.54mm THT pin header; VREF=RX_VAA 2.5V required; do not connect fixed 3.3V pull-ups directly; not JLC-assembled (THT | hand-soldered post-PCBA) — excluded from CPL
C5 | bootstrap capacitor | 47nF X7R | Samsung | CL10B473KB8NNNC | C1622 | selected |  | BOOT1 decoupling close to U1; 47nF 50V X7R 0603 basic (C0G 47nF 0603 unavailable)
C6 | bootstrap capacitor | 47nF X7R | Samsung | CL10B473KB8NNNC | C1622 | selected |  | BOOT2 decoupling close to U1; 47nF 50V X7R 0603 basic (C0G 47nF 0603 unavailable)
C7 | supply decoupling | 4.7uF/25V X5R | Murata | GRM188R61E475KE11D | C90057 | selected |  | VAA analog supply decoupling; matches STEVAL-WLC38RX exactly; 4.7uF 25V X5R 0603
C25 | supply decoupling | 100nF 50V X7R | Wuerth Elektronik | 885012206095 | C6715111 | selected |  | VAA high-frequency bypass close to U1; matches STEVAL-WLC38RX C28 100nF on VAA; 100nF 50V X7R 0603
C8 | supply decoupling | 1uF ceramic | Samsung | CL10A105KB8NNNC | C15849 | selected |  | VDD digital supply decoupling; 1uF 50V X5R 0603 basic (same as C3)
C9 | rectifier decoupling | 10uF/35V X5R | Murata | GRM188R6YA106MA73D | C194427 | selected |  | VRECT rectifier decoupling close to U1; matches STEVAL-WLC38RX (CRECT/COUT family); 10uF 35V X5R 0603 (same as C2)
R5 | I2C pull-up | 10k resistor | UNI-ROYAL | 0603WAF1002T5E | C25804 | selected |  | SCL pull-up to RX_VAA 2.5V for service header
R6 | I2C pull-up | 10k resistor | UNI-ROYAL | 0603WAF1002T5E | C25804 | selected |  | SDA pull-up to RX_VAA 2.5V for service header
R15 | I2C SDA series | 100R resistor | UNI-ROYAL | 0603WAF1000T5E | C22775 | selected |  | I2C SDA service-header series 100Ω placed close to U1.G5; limits ESD/surge current into U1.SDA pad; combined with bring-up adapter ESD strap mitigates HBM at J1
R16 | I2C SCL series | 100R resistor | UNI-ROYAL | 0603WAF1000T5E | C22775 | selected |  | I2C SCL service-header series 100Ω placed close to U1.H5; limits ESD/surge current into U1.SCL pad; combined with bring-up adapter ESD strap mitigates HBM at J1
R7 | NTC pull-up | 51k resistor | UNI-ROYAL | 0603WAF5102T5E | C23196 | selected |  | RX_NTC -> RX_VAA pull-up; forms divider with external 100k/B4260 heater NTC; DS14078 VNTC,OTP typ 0.59V gives ~69C trip with R7=51k
R10 | LED current limit | 3k resistor | UNI-ROYAL | 0603WAF3001T5E | C4211 | selected |  | D1 power-on indicator current limiting from VOUT_12V; 3kΩ 0603 1% basic
R11 | LED current limit | 100R resistor | UNI-ROYAL | 0603WAF1000T5E | C22775 | selected |  | D2 GPIO0 indicator current limiting from RX_VAA (changed 2026-05-17 1k->100R for Vf margin and reliable lighting at I~3mA; see design-notes); 100Ω 0603 1% basic
D1 | power indicator LED | red LED | XINGLIGHT | XL-1608SURC-04 | C965798 | selected |  | VOUT_12V power-on indicator; 0603 red 624nm 20mA
D2 | GPIO0 indicator LED | green LED | XINGLIGHT | XL-1608UGC-04 | C965804 | selected |  | optional GPIO0 active-low indicator; 0603 green 525nm 20mA
C11,C13 | ASK modulation | 10nF/50V C0G | Murata | GRM1885C1H103JA01D | C85973 | selected |  | COMA/COMA2 modulation caps on AC1/AC2-side ASK network; keep 50V rating | do not substitute 25V; 10nF 50V C0G +/-5% 0603 ext (C0G/NP0 for stable ASK modulation depth); swapped from YAGEO CC0603JRNPO9BN103 (C389113 | low JLC stock) to Murata GRM1885C1H103JA01D; initial STEVAL value | verify VRECT/COMA/COMA2/TX demod depth during bring-up
C12 | ASK modulation | 22nF/50V ceramic | Samsung | CL10B223KB8NNNC | C21122 | selected |  | COMB modulation cap on AC1/AC2-side ASK network; keep 50V rating | do not substitute 25V; 22nF 50V X7R 0603 basic; initial STEVAL value | verify VRECT/COMB/TX demod depth during bring-up
C14 | ASK modulation | 22nF/50V ceramic | Samsung | CL10B223KB8NNNC | C21122 | selected |  | COMB2 modulation cap on AC1/AC2-side ASK network; keep 50V rating | do not substitute 25V; 22nF 50V X7R 0603 basic; initial STEVAL value | verify VRECT/COMB/TX demod depth during bring-up
C20,C21 | rectifier bulk | 10uF/35V X5R | Murata | GRM188R6YA106MA73D | C194427 | selected |  | VRECT additional bulk caps to match STEVAL-WLC38RX (3x10uF + HF + TVS); 10uF 35V X5R 0603
C22 | rectifier HF bypass | 100nF 50V X7R | Wuerth Elektronik | 885012206095 | C6715111 | selected |  | VRECT high-frequency decoupling; matches STEVAL-WLC38RX (100nF family); 100nF 50V X7R 0603
C23 | output bulk | 10uF/35V X5R | Murata | GRM188R6YA106MA73D | C194427 | selected |  | VOUT additional bulk cap to match STEVAL-WLC38RX (2x10uF + HF); 10uF 35V X5R 0603
C24 | output HF bypass | 100nF 50V X7R | Wuerth Elektronik | 885012206095 | C6715111 | selected |  | VOUT high-frequency decoupling (replaces C3 1uF); matches STEVAL-WLC38RX (100nF family); 100nF 50V X7R 0603
Z4 | VRECT TVS | unidirectional TVS diode SMB 18V | hongjiacheng | SMBJ18A | C19077573 | selected |  | VRECT OVP clamp to SYS_GND; VR=18V VBR~=20V VC=29.2V@20.55A; 600W 10/1000us; preferred basic; pin2 cathode to VRECT pin1 anode to GND
R12 | INTB pullup | 10k resistor | UNI-ROYAL | 0603WAF1002T5E | C25804 | selected |  | RX_INTB open-drain pullup to RX_VAA; matches ST eval
R13 | ENB pulldown | 10k resistor | UNI-ROYAL | 0603WAF1002T5E | C25804 | selected |  | STWLC38 ENB to SYS_GND pulldown; matches ST STEVAL-WLC38RX; default-enables receiver
MECH-HEATER1 | mechanical / heater assembly | custom flexible silicone heater 12ohm ~12W @ 12V with integrated F1 thermal cutoff and TH2 NTC | JLCPCB | JLC custom flex heater |  | mechanical | https://flexheater.jlcpcb.com/quote | v1 heater assembly ordered as a single SKU from JLC flexible-heater service; 3M 468MP adhesive backing on Non-soldering Side (bonds to MECH-SPREADER1); embeds F1 (Xucheng Elec KSD9700-70/5JSB/080C, C156512) bonded to heater hotspot and TH2 (NCP18WF104F12RB, C71280) at heater representative temperature point; 4-wire harness exits to PCB J2 pads (1=H+,2=NTC,3=NTC_GND,4=H-); OD <=56mm to match PCB; F1 + TH2 + adhesive are part of this assembly — keep their electrical rows for schematic ref tracking but order them via this line
MECH-SPREADER1 | mechanical / heat spreader | internal aluminum heat spreader sheet 0.3mm A5052/A6061 | TBD | A5052-0.3-OD55 |  | mechanical |  | internal heat spreader between cup contact pad and heater; thickness 0.3mm initial (compare 0.2mm / 0.5mm); OD 54-55mm; deburred; must be fully hidden by MECH-PAD1 and integrated retaining lip; bonded to MECH-HEATER1 via heater's 3M 468MP backing; source as small sheet stock and cut/trim to disc
MECH-PAD1 | mechanical / cup contact layer | alumina-filled silicone thermal pad 0.5-1.0mm OD 56-57mm | TBD | TBD |  | mechanical |  | cup contact thermal interface; first candidate is alumina-filled silicone pad; thickness 0.5-1.0mm; OD 56-57mm to fully cover MECH-SPREADER1 and hide its edge; retained mechanically by integrated retaining lip with 5-15% compression; alternates to evaluate: low-hardness thermal silicone sheet 1.0-2.0mm, graphite sheet + thin insulation film (FOD/eddy risk); MPN TBD
MECH-INSUL1 | mechanical / insulation | thin thermal insulation sheet between PCB and heater | TBD | TBD |  | mechanical |  | electrical and thermal insulation between PCB top side and heater underside (F1 clearance side); material/thickness TBD; must survive sustained ~70C; outer notches to clear PCB support ribs; F1 body 0.89mm + installation clearance reserved via f1_clearance_gap=1.4mm — insulation goes between PCB and that gap, not under F1 body
MECH-ENC1 | mechanical / enclosure | bottom tray one-piece with integrated retaining lip | TBD | TBD |  | mechanical |  | one-piece non-metal resin bottom tray; OD 60mm max; wall height ~8.0mm; bottom floor over RX coil 0.8-1.2mm (no metal); side wall 1.5-2.0mm; integrated retaining lip inner OD 55.6mm (lower than pad top, no undercut); 2x PCB support ribs (5.0mm wide x 2.4mm radial) + 4x stack retention ribs (4.0mm wide x ~3.0mm radial); LED viewing hole/light pipe in side wall (open item); prototype via SLA/MJF/SLS/machined resin from enclosure-proto.scad; production resin TBD; no heater cable side-exit hole
MECH-FOOT1 | mechanical / non-slip | bottom silicone ring or feet | TBD | TBD |  | mechanical |  | thin silicone non-slip ring along bottom outer perimeter, or discrete silicone feet; keep clear of Qi pad central footprint; MPN TBD
MECH-ADH1 | mechanical / adhesive | neutral-cure silicone sealant (perimeter use only) | TBD | TBD |  | mechanical |  | optional small-quantity perimeter fixation for MECH-PAD1 if friction retention is insufficient; neutral-cure silicone or thermal silicone adhesive only; do NOT use cyanoacrylate, epoxy, or general double-sided tape; full-area hard bonding of cup contact layer is forbidden
