mash/cupwarmer/hardware/bom/seeed-fusion-bom.csv

Designator | Manufacturer Part Number or Seeed SKU | Qty | Link
U1 | STWLC38JRM | 1 | https://www.lcsc.com/product-detail/C5267845.html
Q1 | 305031501 | 1 | https://statics3.seeedstudio.com/fusion/opl/datasheet/305031501.pdf
D3 | 304020034 | 1 | https://statics3.seeedstudio.com/fusion/opl/datasheet/304020034.pdf
Z1,Z2 | SMF13A | 2 | https://www.lcsc.com/product-detail/C353315.html
Z3 | SMBJ15A | 1 | https://www.lcsc.com/product-detail/C83846.html
Z4 | SMBJ18A | 1 | https://www.lcsc.com/product-detail/C19077573.html
D1 | 304091392 | 1 | https://statics3.seeedstudio.com/fusion/opl/datasheet/304091392.pdf
D2 | 304090043 | 1 | https://statics3.seeedstudio.com/fusion/opl/datasheet/304090043.pdf
C1,C16,C17 | GRM31C5C1H104JA01L | 3 | https://www.lcsc.com/product-detail/C97946.html
C11,C13,C18,C19 | CC0603JRNPO9BN103 | 4 | https://www.lcsc.com/product-detail/C389113.html
C12,C14 | 302010095 | 2 | https://statics3.seeedstudio.com/fusion/opl/datasheet/302010095.pdf
C5,C6 | 302010059 | 2 | https://statics3.seeedstudio.com/fusion/opl/datasheet/302010059.pdf
C4,C22,C24,C25 | 302010138 | 4 | https://statics3.seeedstudio.com/fusion/opl/datasheet/302010138.pdf
C8 | 302012501 | 1 | https://statics3.seeedstudio.com/fusion/opl/datasheet/302012501.pdf
C7 | 302010722 | 1 | https://statics3.seeedstudio.com/fusion/opl/datasheet/302010722.pdf
C2,C9,C20,C21,C23 | GRM188R6YA106MA73D | 5 | https://www.lcsc.com/product-detail/C194427.html
R3 | 301012029 | 1 | https://statics3.seeedstudio.com/fusion/opl/datasheet/301012029.pdf
R11,R15,R16 | 301010184 | 3 | https://statics3.seeedstudio.com/fusion/opl/datasheet/301010184.pdf
R4,R14 | ERJP06F2000V | 2 | https://www.lcsc.com/product-detail/C543538.html
R10 | 301010170 | 1 | https://statics3.seeedstudio.com/fusion/opl/datasheet/301010170.pdf
R2,R5,R6,R12,R13 | 301012845 | 5 | https://statics3.seeedstudio.com/fusion/opl/datasheet/301012845.pdf
R1 | 301010102 | 1 | https://statics3.seeedstudio.com/fusion/opl/datasheet/301010102.pdf
R7 | 301010226 | 1 | https://statics3.seeedstudio.com/fusion/opl/datasheet/301010226.pdf
