mash/cupwarmer/hardware/mechanical/enclosure-proto.stl

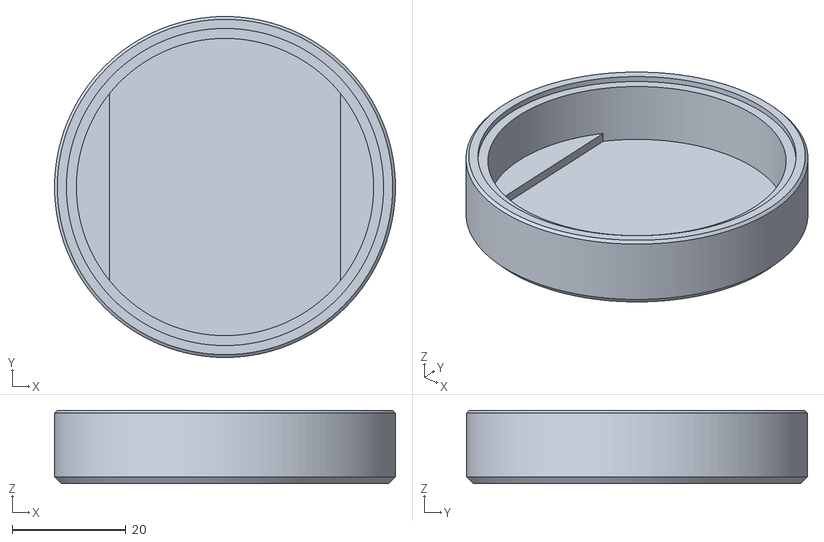
[picture p6: CAD file, 2026-07-26]
hardware/mechanical/enclosure-proto.stl
60.0 x 60.0 x 12.9
