mash/cupwarmer/wiki/source-jlcpcb-wlcsp-assembly-capability.md

---
title: JLCPCB WLCSP 実装要約
type: source-summary
tags: [jlcpcb, wlcsp, assembly, xray, fixture]
sources: [jlcpcb-wlcsp-assembly-capability.md]
created: 2026-04-11
updated: 2026-04-11
---

[JLCPCB WLCSP 実装原文](raw/jlcpcb-wlcsp-assembly-capability.md) から分かるのは、JLCPCB が `WLCSP` を SMT Assembly 対象として扱い、`fixture` と `X-ray inspection` を前提にしていることである。

したがって、`STWLC38JRM` をそのまま受ける保証にはならないが、`WLCSP` 試作外注先として現実的な候補には入る。
