mash/cupwarmer/wiki/source-pcbway-smt-assembly-capabilities.md

---
title: PCBWay SMT Capability 要約
type: source-summary
tags: [pcbway, wlcsp, ubga, xray, via-in-pad]
sources: [pcbway-smt-assembly-capabilities.md]
created: 2026-04-11
updated: 2026-04-11
---

[PCBWay SMT Capability 原文](raw/pcbway-smt-assembly-capabilities.md) は、`uBGA`、`0.2 mm pitch`、`X-Ray machine`、`Via-in-Pad` を扱えると説明している。

`WLCSP` を直接明記してはいないため、`STWLC38JRM` が必ず通るとは言えない。ただし、能力表から見ると `0.4 mm pitch WLCSP40` を扱える可能性は高い。
