mash/cupwarmer/wiki/source-sierra-bga-wlcsp-assembly.md

---
title: Sierra WLCSP 実装要約
type: source-summary
tags: [sierra, wlcsp, assembly, xray, dfm]
sources: [sierra-bga-wlcsp-assembly.md]
created: 2026-04-11
updated: 2026-04-11
---

[Sierra WLCSP 実装原文](raw/sierra-bga-wlcsp-assembly.md) は、`CSP / WLCSP` を明示的に対応範囲へ含め、`X-ray`、`AOI`、`ICT`、`Functional Testing`、`DFM review` を組み合わせるとしている。

そのため、価格より確実性を優先するなら、`STWLC38JRM` 外注実装先としてかなり自然である。
