mash/cupwarmer/wiki/raw/jlcpcb-wlcsp-assembly-capability.md

# JLCPCB WLCSP Assembly Capability

- Source: [JLCPCB Assembly WLCSP examples and package pages](https://jlcpcb.com/partdetail/JLCPCBAssembly-WLCSP/C9900028880)
- Accessed: 2026-04-11

## Notes

- JLCPCB の `WLCSP` 系部品ページでは、`A PCB assembly fixture is needed` としている。
- `X-ray Inspection` は `Required`。
- `WLCSP-12`、`WLCSP-15`、`WLCSP-20`、`WLCSP-28`、`WLCSP-30`、`WLCSP-99` など複数の WLCSP パッケージ例がある。
- 一部は `Standard Only`、一部は `Economic and Standard` とされるが、いずれも hidden joints 向けの `X-ray` を要求している。

## Relevance

- JLCPCB が WLCSP 実装自体をサービス対象としている根拠になる。
- `STWLC38JRM` をそのまま受けるとは限らないが、少なくとも `WLCSP` 一般を完全拒否していない。
