mash/cupwarmer/wiki/raw/pcbway-smt-assembly-capabilities.md

# PCBWay SMT Assembly Capabilities

- Source: [SMT Assembly Capabilities (PCBWay)](https://www.pcbway.com/pcb_prototype/SMT_Assembly_Capabilities.html)
- Accessed: 2026-04-11

## Notes

- PCBWay は `BGA`、`uBGA`、`QFN`、`PoP`、`0.2 mm pitch` の small chip packages を扱えると説明している。
- 検査設備として `X-Ray machine` を明記している。
- PCB 製造側能力として `Via-in-Pad` も案内している。

## Relevance

- `STWLC38JRM` を明示してはいないが、`0.4 mm pitch WLCSP40` に必要な周辺能力は概ね持っていると推測できる。
- これは公式明記ではなく能力からの推定。
