mash/cupwarmer/wiki/raw/sierra-bga-wlcsp-assembly.md

# Sierra Assembly WLCSP Capability

- Source: [BGA Assembly Services (Sierra Assembly)](https://www.sierraassembly.com/pcb-assembly/bga-assembly-services/)
- Accessed: 2026-04-11

## Notes

- Sierra は対応パッケージに `CSP / WLCSP` を明記している。
- hidden joints の評価に `X-ray inspection` を使うと説明している。
- `AOI`、`ICT`、`Functional Testing` を組み合わせるとしている。
- `DFM review to optimize pad geometry and thermal balance` という流れも説明している。

## Relevance

- `WLCSP` を明示的に受ける、より確実寄りの外注候補。
- 試作価格は高くなりやすいと推測されるが、`STWLC38JRM` のような部品では安心感が高い。
