mash/cupwarmer/hardware/test/stwlc38-nvm-wiring.png

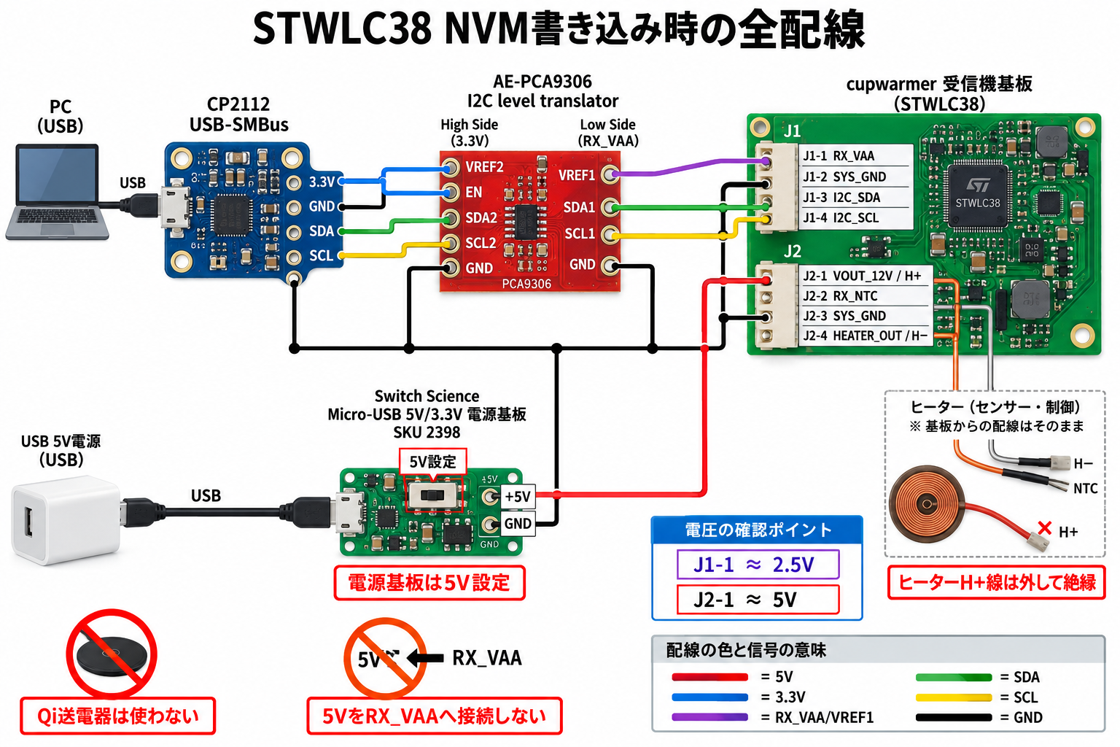
hardware/test/stwlc38-nvm-wiring.png
