mash/cupwarmer/hardware/test/diagrams/cp2112-reference.jpg

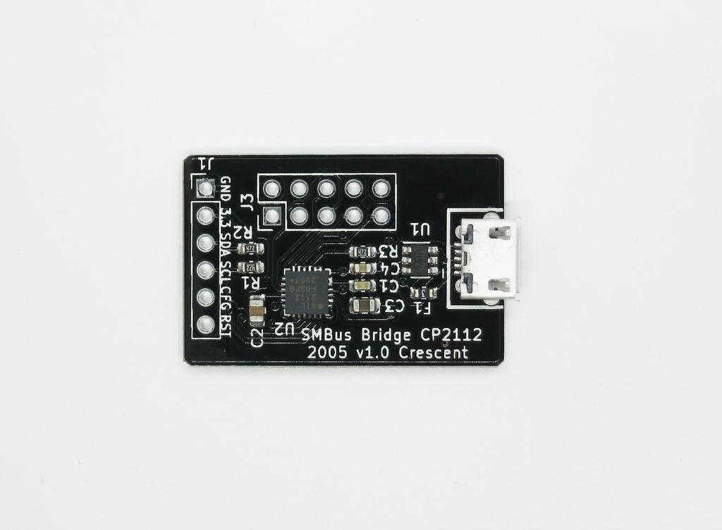
hardware/test/diagrams/cp2112-reference.jpg
