mash/cupwarmer/hardware/test/diagrams/stwlc38-nvm-real-layout.png

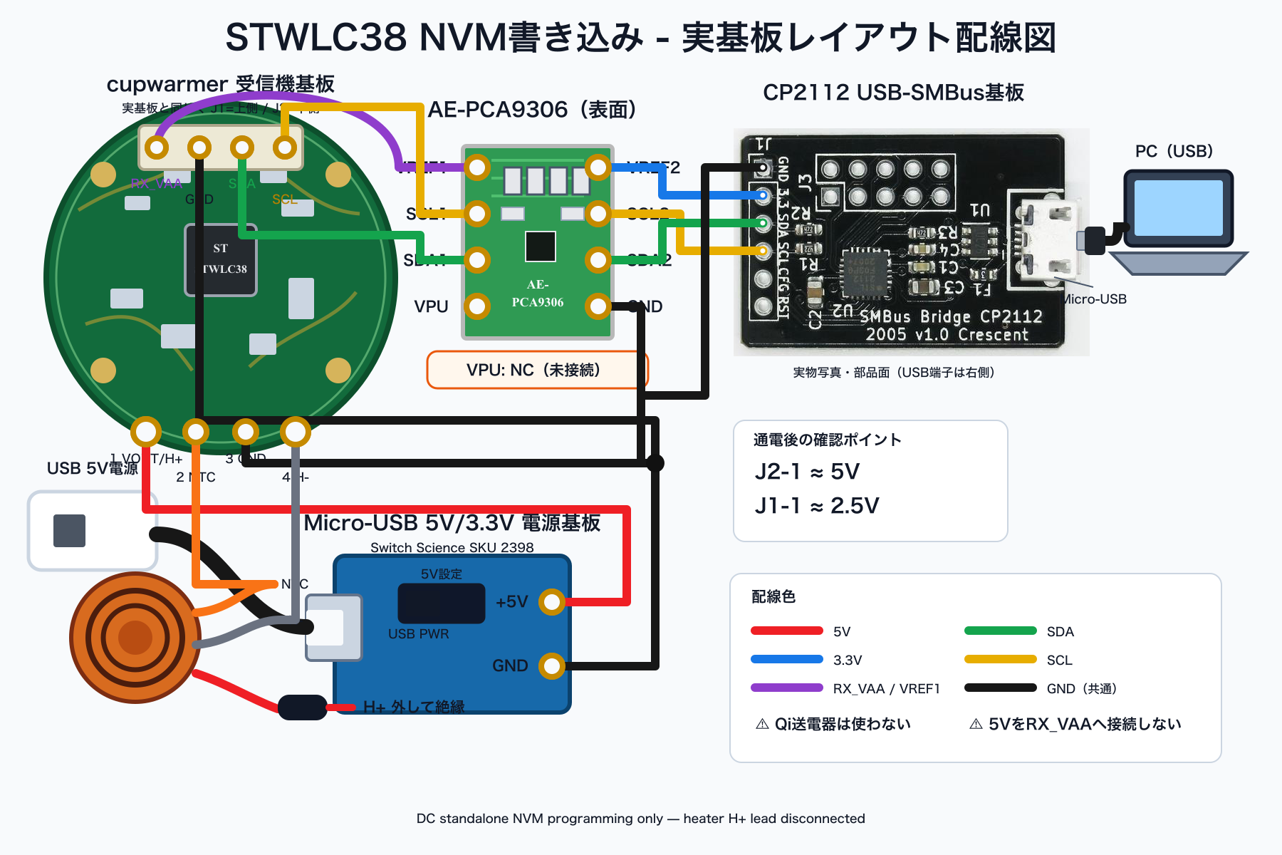
hardware/test/diagrams/stwlc38-nvm-real-layout.png
