mash/cupwarmer/hardware/kicad/cupwarmer-hw/cupwarmer-hw.kicad_pcb

## KiCad design hardware/kicad/cupwarmer-hw/cupwarmer-hw.kicad_pcb (2026-06-13)

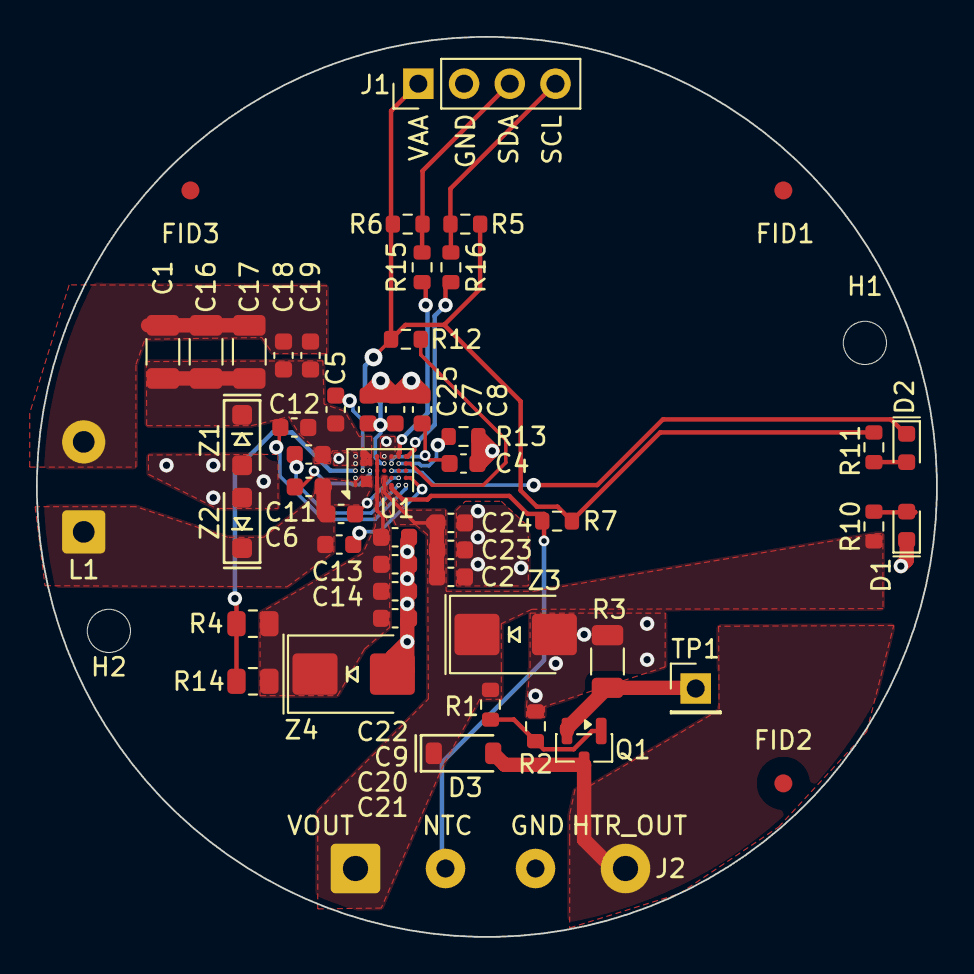
[picture p10: board cupwarmer-hw.kicad_pcb from above]

Board: 4 copper layers, 50.0 x 50.0 mm, 54 parts (0 on the bottom side), 28 nets.

Parts:
C1, C16, C17: 100nF; C_1206_3216Metric
C2, C9, C20, C21, C23: 10uF; C_0603_1608Metric
C4, C22, C24, C25: 100nF; C_0603_1608Metric
C5, C6: 47nF; C_0603_1608Metric
C7: 4.7uF; C_0603_1608Metric
C8: 1uF; C_0603_1608Metric
C11, C13: 10nF/50V; C_0603_1608Metric
C12, C14: 22nF/50V; C_0603_1608Metric
C18, C19: 10nF; C_0603_1608Metric
D1: LED Red; LED_0603_1608Metric
D2: LED Green; LED_0603_1608Metric
D3: B5819W; D_SOD-123
FID1, FID2, FID3: Fiducial; Fiducial_1mm_Mask3mm
H1, H2: MountingHole_M2_Plastic_D2.4mm
J1: I2C Service; PinHeader_1x04_P2.54mm_Vertical
J2: 4-pin heater lead pcb side; SolderWire-HeaterHarness_1x04_P5.0mm_D1.4mm
L1: 8uH; SolderWire-Wuerth760308_1x02_P5.0mm_D1.2mm
Q1: AO3400 SOT-23; SOT-23
R1: 12k Div Top; R_0603_1608Metric
R2: 10k Div Bot; R_0603_1608Metric
R3: 0R/0.05R; R_1206_3216Metric
R4, R14: RCL 200R; R_0805_2012Metric
R5, R6, R12, R13: 10k; R_0603_1608Metric
R7: 51k; R_0603_1608Metric
R10: 3k; R_0603_1608Metric
R11, R15, R16: 100R; R_0603_1608Metric
TP1: TP_I_HEATER_MON; PinHeader_1x01_P2.54mm_Vertical
U1: STWLC38JRM; STWLC38JRM_WLCSP40
Z1: SMF13A Z1; D_SOD-123F
Z2: SMF13A Z2; D_SOD-123F
Z3: SMBJ15A; D_SMB_Pin1K
Z4: SMBJ18A; D_SMB_Pin1K

Connections:
/heater-control/HEATER_OUT: D3.2 (A), J2.4 (H-), Q1.3 (D)
/rx-power/AC1: C1.2, C5.1, C11.1, C12.1, C16.2, C17.2, C18.2, C19.2, U1.B4 (AC1), U1.B5 (AC1), U1.C4 (AC1), U1.C5 (AC1), Z1.1 (K)
/rx-power/AC1 COIL: C1.1, C16.1, C17.1, C18.1, C19.1, L1.2
/rx-power/AC2: C6.1, C13.1, C14.1, L1.1, U1.B1 (AC2), U1.B2 (AC2), U1.C1 (AC2), U1.C2 (AC2), Z2.1 (K)
/rx-power/BOOT1: C5.2, U1.B3 (BOOT1)
/rx-power/BOOT2: C6.2, U1.C3 (BOOT2)
/rx-power/COMA1: C11.2, U1.G1 (COMA1)
/rx-power/COMA2: C13.2, U1.G2 (COMA2)
/rx-power/COMB1: C12.2, U1.H1 (COMB1)
/rx-power/COMB2: C14.2, U1.H2 (COMB2)
/rx-power/LED2: D2.1 (K), U1.F3 (GPIO0)
/rx-power/VRECT: C9.1, C20.1, C21.1, C22.1, R4.2, R14.2, U1.D1 (VRECT), U1.D2 (VRECT), U1.D3 (VRECT), U1.D4 (VRECT), U1.D5 (VRECT), Z4.1 (K)
I2C_SCL: J1.4 (SCL), R5.1, R16.2
I2C_SDA: J1.3 (SDA), R6.1, R15.2
I_HEATER_MON: Q1.2 (S), R3.2, TP1.1 (TP_1)
unnamed: D1.2 (A), R10.2
unnamed: D2.2 (A), R11.2
unnamed: Q1.1 (G), R1.2, R2.2
unnamed: R13.1, U1.G4 (ENB)
unnamed: R4.1, R14.1, U1.A3 (IEXT)
unnamed: R12.1, U1.H4 (INTB)
unnamed: R16.1, U1.H5 (SCL)
unnamed: R15.1, U1.G5 (SDA)
RX_NTC: J2.2 (NTC), R7.2, U1.F1 (NTC)
RX_VAA: C7.2, C25.2, J1.1 (VREF), R5.2, R6.2, R7.1, R11.1, R12.2, U1.E4 (VAA)
RX_VDD: C4.2, C8.2, U1.F4 (VDD)
SYS_GND: C2.1, C4.1, C7.1, C8.1, C9.2, C20.2, C21.2, C22.2, C23.1, C24.1, C25.1, D1.1 (K), J1.2 (GND), J2.3 (NTC_GND), R2.1, R3.1, R13.2, U1.A1 (VSSP), U1.A2 (VSSP), U1.A4 (VSSP), U1.A5 (VSSP), U1.E5 (VSSA), U1.F5 (VSSD), Z1.2 (A), Z2.2 (A), Z3.2 (A), Z4.2 (A)
VOUT_12V: C2.2, C23.2, C24.2, D3.1 (K), J2.1 (H+), R1.1, R10.1, U1.E1 (VOUT), U1.E2 (VOUT), Z3.1 (K)
