mash/cupwarmer/.agents/skills/kicad-schematic-score/scripts/score_schematic.py

#!/usr/bin/env python3
from __future__ import annotations

import argparse
import json
import subprocess
import sys
import tempfile
from dataclasses import asdict, dataclass
from pathlib import Path

SCRIPT_DIR = Path(__file__).resolve().parent
SKILLS_DIR = SCRIPT_DIR.parents[1]

if str(SCRIPT_DIR) not in sys.path:
    sys.path.insert(0, str(SCRIPT_DIR))
sys.path.insert(0, "/Users/mash/src/github.com/mvnmgrx/kiutils/src")

from kiutils.schematic import Schematic
from kicad_sch_bbox_collisions import (
    collect_symbol_boxes,
    collect_text_targets,
    collect_wires,
    detect_collisions,
    match_rendered_to_targets,
    parse_svg_rendered_texts,
)

KICAD_CLI = "/Applications/KiCad/KiCad.app/Contents/MacOS/kicad-cli"
WIRE_CORNER_WEIGHT = 25.0
SYMBOL_WIRE_CONFLICT_WEIGHT = 1200.0
SYMBOL_WIRE_CLEARANCE_MM = 1.27
SYMBOL_WIRE_CLEARANCE_WEIGHT = 450.0


@dataclass
class ScoreBreakdown:
    total: float
    collision_count: int
    wire_hits: int
    component_hits: int
    text_hits: int
    collision_area: float
    wire_corner_count: int
    wire_corner_penalty: float
    symbol_wire_conflict_count: int
    symbol_wire_penalty: float
    symbol_wire_clearance_count: int
    symbol_wire_clearance_penalty: float


def rect_area(rect: dict | None) -> float:
    if not rect:
        return 0.0
    return max(0.0, rect["x2"] - rect["x1"]) * max(0.0, rect["y2"] - rect["y1"])


def point_key(point: tuple[float, float]) -> tuple[float, float]:
    return (round(point[0], 2), round(point[1], 2))


def direction_from(point: tuple[float, float], other: tuple[float, float]) -> tuple[int, int] | None:
    dx = round(other[0] - point[0], 2)
    dy = round(other[1] - point[1], 2)
    if abs(dx) < 0.01 and abs(dy) < 0.01:
        return None
    sx = 0 if abs(dx) < 0.01 else (1 if dx > 0 else -1)
    sy = 0 if abs(dy) < 0.01 else (1 if dy > 0 else -1)
    return (sx, sy)


def is_corner_directions(a: tuple[int, int], b: tuple[int, int]) -> bool:
    if a == b:
        return False
    if a[0] == -b[0] and a[1] == -b[1]:
        return False
    return True


def _point_on_wire_segment(
    point: tuple[float, float],
    wire,
    tolerance: float = 0.02,
) -> bool:
    px, py = point
    x1, y1 = wire.p1
    x2, y2 = wire.p2
    if abs(x1 - x2) < tolerance:
        return abs(px - x1) < tolerance and min(y1, y2) - tolerance <= py <= max(y1, y2) + tolerance
    if abs(y1 - y2) < tolerance:
        return abs(py - y1) < tolerance and min(x1, x2) - tolerance <= px <= max(x1, x2) + tolerance
    return False


def _is_wire_endpoint(
    point: tuple[float, float],
    wire,
    tolerance: float = 0.02,
) -> bool:
    px, py = point
    return (
        abs(px - wire.p1[0]) < tolerance
        and abs(py - wire.p1[1]) < tolerance
        or abs(px - wire.p2[0]) < tolerance
        and abs(py - wire.p2[1]) < tolerance
    )


def count_wire_t_junction_corners(wires: list) -> int:
    t_junctions: set[tuple[float, float, str, str]] = set()
    for endpoint_wire in wires:
        endpoint_orientation = _wire_orientation(endpoint_wire)
        if endpoint_orientation is None:
            continue
        for endpoint in (endpoint_wire.p1, endpoint_wire.p2):
            point = point_key(endpoint)
            for segment_wire in wires:
                if segment_wire.uuid == endpoint_wire.uuid:
                    continue
                segment_orientation = _wire_orientation(segment_wire)
                if segment_orientation is None or segment_orientation == endpoint_orientation:
                    continue
                if _is_wire_endpoint(point, segment_wire):
                    continue
                if not _point_on_wire_segment(point, segment_wire):
                    continue
                wire_ids = tuple(sorted((endpoint_wire.uuid, segment_wire.uuid)))
                t_junctions.add((point[0], point[1], wire_ids[0], wire_ids[1]))
    return len(t_junctions)


def count_wire_corners(wires: list) -> int:
    incidents: dict[tuple[float, float], list[tuple[int, int]]] = {}
    for wire in wires:
        p1 = point_key(wire.p1)
        p2 = point_key(wire.p2)
        d1 = direction_from(p1, p2)
        d2 = direction_from(p2, p1)
        if d1 is not None:
            incidents.setdefault(p1, []).append(d1)
        if d2 is not None:
            incidents.setdefault(p2, []).append(d2)

    corners = 0
    for directions in incidents.values():
        if len(directions) != 2:
            continue
        if is_corner_directions(directions[0], directions[1]):
            corners += 1
    return corners + count_wire_t_junction_corners(wires)


def _wire_endpoint_on_symbol_pin(
    wire,
    pin_points: list[tuple[float, float]],
    tolerance: float = 0.11,
) -> bool:
    for x, y in pin_points:
        if abs(wire.p1[0] - x) < tolerance and abs(wire.p1[1] - y) < tolerance:
            return True
        if abs(wire.p2[0] - x) < tolerance and abs(wire.p2[1] - y) < tolerance:
            return True
    return False


def _wire_orientation(wire) -> str | None:
    if abs(wire.p1[0] - wire.p2[0]) < 0.01:
        return "vertical"
    if abs(wire.p1[1] - wire.p2[1]) < 0.01:
        return "horizontal"
    return None


def _symbol_long_axis(box) -> str:
    rect = box.bbox.normalized()
    return "horizontal" if (rect.x2 - rect.x1) >= (rect.y2 - rect.y1) else "vertical"


def _interval_overlap(a1: float, a2: float, b1: float, b2: float) -> float:
    return max(0.0, min(a2, b2) - max(a1, b1))


def _clearance_conflict_details(box, wire, clearance: float) -> dict | None:
    rect = box.bbox.normalized()
    orientation = _wire_orientation(wire)
    if orientation is None or orientation != _symbol_long_axis(box):
        return None
    if _wire_endpoint_on_symbol_pin(wire, box.pin_points):
        return None

    if orientation == "vertical":
        x = wire.p1[0]
        y1, y2 = sorted((wire.p1[1], wire.p2[1]))
        overlap_span = _interval_overlap(y1, y2, rect.y1, rect.y2)
        if overlap_span <= 0.5:
            return None
        if x < rect.x1:
            orth_distance = rect.x1 - x
            if orth_distance > clearance + 0.01:
                return None
            return {
                "side": "left",
                "orth_distance": round(orth_distance, 3),
                "overlap_span": round(overlap_span, 3),
                "preferred_dx": -1.0,
                "preferred_dy": 0.0,
            }
        if x > rect.x2:
            orth_distance = x - rect.x2
            if orth_distance > clearance + 0.01:
                return None
            return {
                "side": "right",
                "orth_distance": round(orth_distance, 3),
                "overlap_span": round(overlap_span, 3),
                "preferred_dx": 1.0,
                "preferred_dy": 0.0,
            }
        return None

    y = wire.p1[1]
    x1, x2 = sorted((wire.p1[0], wire.p2[0]))
    overlap_span = _interval_overlap(x1, x2, rect.x1, rect.x2)
    if overlap_span <= 0.5:
        return None
    if y < rect.y1:
        orth_distance = rect.y1 - y
        if orth_distance > clearance + 0.01:
            return None
        return {
            "side": "top",
            "orth_distance": round(orth_distance, 3),
            "overlap_span": round(overlap_span, 3),
            "preferred_dx": 0.0,
            "preferred_dy": -1.0,
        }
    if y > rect.y2:
        orth_distance = y - rect.y2
        if orth_distance > clearance + 0.01:
            return None
        return {
            "side": "bottom",
            "orth_distance": round(orth_distance, 3),
            "overlap_span": round(overlap_span, 3),
            "preferred_dx": 0.0,
            "preferred_dy": 1.0,
        }
    return None


def detect_symbol_wire_conflicts(
    wires: list,
    symbol_boxes: list,
    margin: float = 0.0,
    clearance: float = SYMBOL_WIRE_CLEARANCE_MM,
) -> list[dict]:
    conflicts: list[dict] = []
    seen: set[tuple[str, str, str]] = set()
    for box in symbol_boxes:
        rect = box.bbox.normalized()
        expanded = rect.expanded(clearance, clearance)
        for wire in wires:
            conflict_kind: str | None = None
            clearance_details: dict | None = None
            if rect.intersects_segment(wire.p1, wire.p2, margin=margin):
                conflict_kind = "overlap"
            elif (
                clearance > 0
                and box.lib_id.endswith("PASSIVE_2")
                and expanded.intersects_segment(wire.p1, wire.p2, margin=margin)
            ):
                clearance_details = _clearance_conflict_details(box, wire, clearance)
                if clearance_details is not None:
                    conflict_kind = "clearance"
            if conflict_kind is None:
                continue
            key = (box.ref, wire.uuid, conflict_kind)
            if key in seen:
                continue
            seen.add(key)
            conflicts.append(
                {
                    "kind": conflict_kind,
                    "ref": box.ref,
                    "lib_id": box.lib_id,
                    "bbox": asdict(rect),
                    "expanded_bbox": asdict(expanded.normalized()) if conflict_kind == "clearance" else None,
                    "clearance_side": None if clearance_details is None else clearance_details["side"],
                    "orth_distance": None if clearance_details is None else clearance_details["orth_distance"],
                    "overlap_span": None if clearance_details is None else clearance_details["overlap_span"],
                    "preferred_dx": 0.0 if clearance_details is None else clearance_details["preferred_dx"],
                    "preferred_dy": 0.0 if clearance_details is None else clearance_details["preferred_dy"],
                    "wire": {
                        "uuid": wire.uuid,
                        "p1": wire.p1,
                        "p2": wire.p2,
                    },
                }
            )
    return conflicts


def export_svg(schematic: Path, outdir: Path) -> Path:
    subprocess.run(
        [KICAD_CLI, "sch", "export", "svg", "--output", str(outdir), str(schematic)],
        cwd=SKILLS_DIR.parents[1],
        check=True,
        stdout=subprocess.DEVNULL,
        stderr=subprocess.DEVNULL,
    )
    svgs = sorted(outdir.glob("*.svg"))
    if not svgs:
        raise FileNotFoundError(f"no SVG exported into {outdir}")
    return svgs[0]


def collision_payload(schematic: Path, svg: Path, margin: float = 0.0) -> dict:
    sch = Schematic.from_file(str(schematic))
    rendered = parse_svg_rendered_texts(svg)
    targets = collect_text_targets(sch)
    matched = match_rendered_to_targets(rendered, targets)
    wires = collect_wires(sch)
    boxes = collect_symbol_boxes(sch)
    collisions = detect_collisions(matched, wires, boxes, margin=margin)
    symbol_wire_conflicts = detect_symbol_wire_conflicts(wires, boxes, margin=margin)
    return {
        "collisions": collisions,
        "wires": wires,
        "symbol_wire_conflicts": symbol_wire_conflicts,
    }


def score_payload(payload: dict) -> ScoreBreakdown:
    collisions = payload["collisions"]
    wires = payload["wires"]
    symbol_wire_conflicts = payload["symbol_wire_conflicts"]
    wire_hits = sum(len(c["wire_hits"]) for c in collisions)
    component_hits = sum(len(c["component_hits"]) for c in collisions)
    text_hits = sum(len(c["text_hits"]) for c in collisions)
    collision_area = sum(rect_area(c.get("collision_bbox")) for c in collisions)
    wire_corner_count = count_wire_corners(wires)
    wire_corner_penalty = wire_corner_count * WIRE_CORNER_WEIGHT
    symbol_wire_conflict_count = sum(1 for conflict in symbol_wire_conflicts if conflict.get("kind") == "overlap")
    symbol_wire_penalty = symbol_wire_conflict_count * SYMBOL_WIRE_CONFLICT_WEIGHT
    symbol_wire_clearance_count = sum(1 for conflict in symbol_wire_conflicts if conflict.get("kind") == "clearance")
    symbol_wire_clearance_penalty = symbol_wire_clearance_count * SYMBOL_WIRE_CLEARANCE_WEIGHT
    total = (
        1000.0 * wire_hits
        + 1000.0 * component_hits
        + 800.0 * text_hits
        + 50.0 * len(collisions)
        + collision_area
        + wire_corner_penalty
        + symbol_wire_penalty
        + symbol_wire_clearance_penalty
    )
    return ScoreBreakdown(
        total=round(total, 3),
        collision_count=len(collisions),
        wire_hits=wire_hits,
        component_hits=component_hits,
        text_hits=text_hits,
        collision_area=round(collision_area, 3),
        wire_corner_count=wire_corner_count,
        wire_corner_penalty=wire_corner_penalty,
        symbol_wire_conflict_count=symbol_wire_conflict_count,
        symbol_wire_penalty=symbol_wire_penalty,
        symbol_wire_clearance_count=symbol_wire_clearance_count,
        symbol_wire_clearance_penalty=symbol_wire_clearance_penalty,
    )


def score_schematic(schematic: Path, margin: float = 0.0) -> dict:
    with tempfile.TemporaryDirectory(prefix="kicad-layout-score-") as tmpdir:
        svg = export_svg(schematic, Path(tmpdir))
        payload = collision_payload(schematic, svg, margin=margin)
    score = score_payload(payload)
    return {
        "score": asdict(score),
        "collisions": payload["collisions"],
        "symbol_wire_conflicts": payload["symbol_wire_conflicts"],
    }


def main() -> int:
    ap = argparse.ArgumentParser(
        description="Evaluate the current KiCad schematic layout and assign penalty points without modifying it."
    )
    ap.add_argument("schematic", type=Path)
    ap.add_argument("--margin", type=float, default=0.0)
    args = ap.parse_args()
    print(json.dumps(score_schematic(args.schematic, margin=args.margin), ensure_ascii=False, indent=2))
    return 0


if __name__ == "__main__":
    raise SystemExit(main())
