mash/cupwarmer/(commit log)

2026-04-12 add hardware schematics, wiki, skills, and project docs
    Initial project structure: KiCad schematic files for cup warmer
    (rx-power, heater-control, sensors-logic), research wiki,
    Claude skills for hardware editing and kiutils roundtrip validation.
    [cupwarmer-hw.kicad_pcb, cupwarmer-hw.kicad_sch, heater-control.kicad_sch, initial-bom.csv, rx-power.kicad_sch, sensors-logic.kicad_sch]
2026-04-12 update kicad-hardware-editing skill to use patched kiutils
    Add kiutils setup section with import path and supported v8+ tokens.
    Replace raw S-expression editing with kiutils-based Python workflow.
    Add 4-step validation: roundtrip coverage, kicad-cli ERC/netlist,
    full validation script, and text-level checks.
    [heater-control.kicad_sch, initial-bom.csv, rx-power.kicad_sch]
2026-04-12 Refactor KiCad editing skills
2026-04-17 Move skills into .agents and update text collision detection
    [kicad_sch_bbox_collisions.py]
2026-04-17 Update hardware schematics and BOM
    [heater-control.kicad_sch, initial-bom.csv, rx-power.kicad_sch, sensors-logic.kicad_sch]
2026-04-17 Ignore KiCad local project files
2026-04-18 Add KiCad layout optimization skill
2026-04-18 Optimize rx-power schematic layout
    [rx-power.kicad_sch]
2026-04-19 Fix KiCad schematic connectivity and symbol sync
    [heater-control.kicad_sch, rx-power.kicad_sch, sensors-logic.kicad_sch]
2026-04-25 Improve schematic layout clearance scoring
    [kicad_sch_bbox_collisions.py]
2026-04-25 Refine KiCad schematic layout
    [heater-control.kicad_sch, rx-power.kicad_sch, sensors-logic.kicad_sch]
2026-04-25 Penalize schematic label pin conflicts
    [heater-control.kicad_sch]
2026-04-25 Remove KiCad layout optimize skill
2026-04-25 Remove schematic edit skill
2026-04-25 Add schematic score skill and update KiCad workflows
    Introduce kicad-schematic-score skill, and revise kicad-hardware-editing
    and kicad-validate to drop the subagent orchestration model in favor of
    direct edits, score-based readability checks, and current sheet hierarchy.
2026-04-26 Tighten KiCad skills and drop kiutils edit path
    - kicad-hardware-editing: collapse Key Rules into bullets, add worked
    example for adding a global label, drop kiutils as an edit option
    - kicad-validate: pin ERC/netlist to top-level sheet, document
    intentional-violation exception, remove speculative tmp/ helpers
    - kicad-schematic-score: tighten script and metric descriptions,
    surface dominant penalty contributors when collisions are low
2026-04-26 Refactor KiCad skills around unified tool
2026-04-26 Tighten KiCad skills via empirical tuning
    Compress kicad-tool, kicad-validate, and kicad-hardware-editing
    SKILL.md files (350 -> 204 lines, -42%) while keeping baseline
    subagent task accuracy at 100%. Collapse duplicated command
    examples into a single command table in kicad-tool, route
    kicad-validate through the one-shot `sch validate`, and clarify
    `--only-text` regex semantics plus pre/post baseline filenames.
2026-04-26 Improve KiCad inspect layout metrics
2026-04-26 Clean up sensors logic schematic layout
    [sensors-logic.kicad_sch]
2026-04-26 Improve rx power NTC schematic layout
    [rx-power.kicad_sch]
2026-04-26 Clean up rx power label layout
    [rx-power.kicad_sch]
2026-04-26 Route rx power C2 net around symbol
    [rx-power.kicad_sch]
2026-04-26 Tune kicad inspect: relax label endpoint, add diagonal & pin-text checks
    - Allow wire endpoints reaching a global_label anchor to overlap the
    label frame up to half its perpendicular extent (was 0.05mm), so
    legit connections no longer count as collisions.
    - Drop the matched-only filter on rendered texts so pin numbers can
    trigger text_hits when a Reference (e.g. TVS1, U1) lands on top.
    - Add diagonal_wire_count / diagonal_wire_penalty (50/segment).
    - Document orthogonal-wire and component Value placement preferences
    in kicad-hardware-editing.
    [kicad_sch_bbox_collisions.py, score_schematic.py]
2026-04-26 Shorten rx-power local wires
    [rx-power.kicad_sch]
2026-04-26 Improve rx-power readability and inspect score
    Move annotation notes off the circuit area, straighten the diagonal
    wire, and shift TVS1/U1/C5/R5 reference & value text away from pin
    numbers. Score: 10936 -> 1445 (12 collisions -> 1).
    [rx-power.kicad_sch]
2026-04-26 Improve KiCad layout cleanup guidance
2026-04-26 Split KiCad schematic editing into functional and cleanup stages
    Scope kicad-hardware-editing to stage 1 (connectivity, ERC, netlist) and
    add kicad-sch-cleanup-loop for stage 2 score/layout tightening.
2026-04-26 Rewrite STWLC38JRM_MIN symbol to 40-ball BGA pinout
    Replace the 20-pin planning placeholder with the real STWLC38JRM
    pinout from DS14078 p.4-5. Pin numbers now use BGA designators
    (A1..H5), and pin names match the datasheet. Layout follows the
    4-sided arrangement requested by the user (E3 labelled VMID and
    F2 labelled DFT per the reference image).
    Existing rx-power wires no longer align with the new pin geometry;
    ERC rises from 16 to 80 violations as expected. Re-routing is a
    follow-up task.
    [rx-power.kicad_sch]
2026-04-26 Switch I2C/NTC pull-ups to RX_VAA and bump heater to 15R
    - Pull-ups for SCL/SDA and NTC monitor nodes move from RX_VDD
    (1.1 V, too low for I2C) to RX_VAA (2.5 V).
    - Heater value updated from 10 R to 15 R to keep dissipation
    within the EPP 15 W envelope after efficiency losses, avoiding
    VOUT droop and OCP trips.
    - Design notes refreshed to reflect the DS14078 Figure 13 / Table 36
    alignment, ASK/ESD/Cd parts, and v1 fixed-on heater gate plan.
    - Add untracked rx-power.kicad_pcb / rx-power.kicad_pro stubs.
    [heater-control.kicad_sch, rx-power.kicad_pcb, sensors-logic.kicad_sch]
2026-04-26 Add GPIO0 status LED to rx schematic
    [rx-power.kicad_sch]
2026-04-26 Point kicad-hardware-editing at kicad-tool skill for CLI usage
    Avoid guessing subcommands and flags by directing readers to the
    authoritative kicad-tool skill before any CLI invocation.
2026-04-26 Refine STWLC38JRM_MIN pin layout and rx-power instance
    Repositions VSSP/VRECT/VOUT pins on the STWLC38JRM_MIN symbol and updates
    the rx-power schematic instance to match, including passive pin types
    and adjusted property positions.
    [rx-power.kicad_sch]
2026-04-26 Add sch query/edit subcommands and validate baseline diff to kicad-tool
    Unify schematic CLI under (read | edit) x element to make the obvious
    tool obvious per use case. New commands:
    - sch query symbol/pin/net/region/wire/label/lib-symbol/list - read-only
    inspection that previously required ad-hoc grep over .kicad_sch.
    - sch edit symbol move | wire add/delete | label add/move/delete |
    junction add/delete - text-preserving S-expression mutation with
    --dry-run; cascades property (at)s on symbol move; clones sibling
    blocks for labels.
    - sch validate --save-baseline DIR / --baseline DIR - pre/post diff of
    ERC, netlist, and inspect; exits non-zero on net regression.
    Skill docs (kicad-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
2026-04-27 Fix sch query pin syntax in kicad-hardware-editing skill
    Replace the incorrect `sch query pin --ref REF [--number N]` form with
    the actual positional `sch query pin REF.PIN` form. Found via
    empirical-prompt-tuning iteration 0 (description/body alignment check).
2026-04-28 Score schematic edge-hugging wires
2026-04-29 Tidy rx-power schematic wiring
    [rx-power.kicad_sch]
2026-04-29 Add sch edit symbol add-pin and Step 0 plan workflow
    - kicad-tool: add `sch edit symbol add-pin` that updates the schematic's
    embedded `lib_symbols` and the standalone `cupwarmer.kicad_sym` together,
    with duplicate-number detection and dry-run support.
    - kicad-hardware-editing: add a mandatory Step 0 (Goal / Problem / Approach
    / Placement / ASCII layout sketch with current+proposed) and require user
    approval before any sch edit. Skip exceptions: trivial single-action
    requests, and autonomous-iteration contexts like /kicad-sch-cleanup-loop.
    - kicad-hardware-editing & kicad-sch-cleanup-loop: forbid raw Read/cat/grep
    of `.kicad_sch`; route all inspection through `sch query`. If the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
2026-04-29 Make required CLI args positional in kicad-tool
    Promote required arguments to positional and keep `--flag` only for
    optional or mutually-exclusive selectors. `add-pin` no longer encodes
    rotation in `--at`; use `--rotation` like every other edit. `query net`
    now takes a single positional that accepts either a net name or
    `REF.PIN` (dispatched by `.`). Skill docs updated to match.
2026-04-29 Document kicad-tool argument conventions
    Add a short "Argument conventions" section so agents can write correct
    invocations without consulting `--help`: schematic is always first,
    required args are positional in table order, coordinates are a single
    `X,Y`, rotation is a separate `--rotation`, and flags are reserved for
    optional knobs and mutex selectors.
2026-04-29 Update rx-power schematic: relocate C4 and R7, tidy SYS_GND connections
    Relocate C4 (100nF bypass) and R7 (10k NTC pull-up) within the rx-power
    schematic. Update SYS_GND label placement and adjust wiring to match
    the new component locations.
    [rx-power.kicad_sch]
2026-04-29 Add `sch edit symbol move-property` for property placement edits
    This extends the repo-local `kicad-tool` CLI to relocate symbol fields like `Reference`/`Value` (and optional rotation) without moving the whole symbol.
    Made-with: Cursor
2026-04-29 Refactor kicad skills: split design principles, JSON-default CLI, drop SVG export
    - Add electronics-design-principles skill (invariants, partitioning, grouping, forbidden patterns)
    - Strip design judgement and project-specific paths out of kicad-hardware-editing
    - Add `sch render-region` for cropped PNG output; drop user-facing `sch render-svg` (open KiCad to view full sheet)
    - Drop SVG export step from `sch validate` (inspect re-renders internally)
    - Replace `--json` boolean with `--format {json,text}` (default `json`); query commands always emit JSON
    - Add CLAUDE.md documenting `./tmp/` scratch convention and stable-filename rule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
2026-04-29 Tidy rx-power schematic and restore SYS_GND on U1 ENB
    Reorganize junctions and wire layout in rx-power sheet. Re-add the
    SYS_GND global label at U1 pin G4 (ENB) and remove a stray wire stub
    near C9 to fix two new ERC issues introduced by the layout changes.
    Remaining ERC findings (E4/F4 power-output pair, RX_INTB isolated
    label) are pre-existing.
    [rx-power.kicad_sch]
2026-04-29 Fix rx-power ERC: separate VDD net, no-connect INTB
    - Rename the global label at (194.31, 137.16) from RX_VAA to RX_VDD so
    the C7/C4/C8 decoupling network sits on VDD instead of shorting U1
    pins E4 (VAA) and F4 (VDD), both Power outputs.
    - Disconnect RX_INTB on this sheet: remove the global label and stub
    wire at U1 pin H4, and add a no_connect flag to silence the isolated
    pin warning.
    ERC: 0 errors, 0 warnings.
    [rx-power.kicad_sch]
2026-04-29 Update rx-power: rename U1 pins VMID→NC, DFT→VS
    - Rename STWLC38 pins to match datasheet: VMID→NC, DFT→VS
    - Remove C10 (VS bypass) — VS unused in RX-only mode
    - Relocate U1 and C7, reroute RX_VDD/SYS_GND wiring
    - Add RX_INTB global label at U1 INTB pin
    - Update design-notes: IEXT clamp routes via VRECT, document GPIO0
    LED (D2/R11) and INTB open-drain note
    [rx-power.kicad_sch]
2026-04-29 Add AO3400 MOSFET datasheet summary to wiki
    Ingest Shenzhen Hottech AO3400 datasheet PDF and add a source-summary
    page covering the SOT-23 logic-level N-MOSFET (30V / 5.8A / 28mΩ@10V)
    for use in Cup Warmer auxiliary load-switch and PWM control contexts.
2026-04-29 Switch heater gate drive to 10k/10k divider for VGS margin
    Replace R1 (33R series) / R2 (100k pull-down) with a 10k/10k divider
    from VOUT_12V to SYS_GND. VGS settles at ~6V, well within the
    +/-12V VGS_max of AO3400-class FETs even on VOUT spikes, while still
    fully enhancing a logic-level N-FET. Heater current (0.8A through
    15 ohm at 12V) gives ~18mW MOSFET dissipation, which SOT-23 handles
    with large thermal margin -- no need for a power package.
    Updates heater-control.kicad_sch (R1/R2 values + descriptive note),
    docs/design-notes.md (control policy + schematic-status section),
    and hardware/bom/initial-bom.csv (R1/R2 rows). ERC: 0 violations.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
    [heater-control.kicad_sch, initial-bom.csv]
2026-04-29 Fix MOSFET D/S pin labels and tidy rx-power layout
    [rx-power.kicad_sch]
2026-04-29 Tie TH2 to RX_NTC for STWLC38 internal OTP coverage
    Move TH2 (10k NTC) from a standalone NTC_PCB net into the RX_NTC
    divider so the STWLC38JRM internal OTP can read board/coil
    hotspot temperature directly. R7 (10k -> RX_VAA, on rx-power
    sheet) now forms the upper half of the divider with TH2 as the
    lower half (~RX_VAA/2 at 25C); the redundant R9 pull-up on
    sensors-logic is removed. NTC_TOP (TH1) keeps its existing
    RX_VAA/R8 pull-up and J2 monitor tap since the IC has only one
    NTC pin.
    TH2 should be placed near the Qi coil/ferrite during layout so
    the IC can autonomously throttle/stop on coil overheat -- a
    second autonomous protection layer alongside the F1 thermostat.
    Updates sensors-logic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
    [initial-bom.csv, rx-power.kicad_sch, sensors-logic.kicad_sch]
2026-04-29 Refactor cleanup-loop into Phase 0 planning, fix --json mis-doc
    Reorganize kicad-sch-cleanup-loop around a mandatory Phase 0 area-level
    plan (cluster identification, ordering, dependency tracking) before any
    subagent dispatches an edit. Replace the greedy score-driven inner loop
    with planned cluster execution and stable tmp/ filename reuse.
    Fix kicad-hardware-editing and kicad-sch-cleanup-loop docs that
    referenced a non-existent `--json` flag — the CLI uses
    `--format {json,text}` (default `json`). Update the validate examples to
    the correct invocation and warn against `2>&1` corrupting JSON output.
2026-04-29 Tidy RX_NTC/RX_VAA labels around R7/C7 in rx-power
    Move RX_NTC off the mid-wire position by adding a short horizontal stub
    off R7.1 and anchoring the label at the stub endpoint. Rotate RX_VAA so
    its text extends left along the existing R7.2-C7.2 wire instead of down
    over C7's body. Sheet inspect score 15510 -> 11264, ERC unchanged.
    [rx-power.kicad_sch]
2026-04-29 Move RX_VAA off C7.2 pin endpoint via stub left of R7.2
    Add a horizontal stub (139.7,142.24)-(144.78,142.24) off R7.2 and
    re-anchor RX_VAA at the new stub endpoint (angle 0). Mirror of the
    RX_NTC fix: label tip now lands on a free wire endpoint instead of
    overlapping C7.2's pin segment. Sheet inspect score 11264 -> 9194,
    ERC unchanged.
    [rx-power.kicad_sch]
2026-04-29 Update rx-power schematic layout and wiring
    Reflow junctions, wires, and label/value placements in rx-power.kicad_sch.
    [rx-power.kicad_sch]
2026-04-29 Require netlist-parity gate when wires are deleted or relocated
    ERC parity alone misses orphaned mid-span taps when a wire delete
    leaves a junction or another wire still terminating at the same
    coordinate. Funnel both skills through kicad-validate's existing
    baseline-diff workflow (--save-baseline / --baseline) so the
    removed_nodes check is what gates acceptance, and call out the
    mid-span-tap audit before the destructive edit.
2026-04-29 Rename kicad-tool wrapper flag --out to --output
    Match the kicad-cli passthrough flag so every output destination on
    sch render-region and sch netlist uses one name. No backward-compat
    alias.
2026-04-29 Document thermal safety design
    [initial-bom.csv]
2026-04-29 Add inline invocation examples to kicad-tool SKILL.md
    Annotate render-region, query symbol, query pin, and edit symbol move
    rows with concrete `<br>e.g. ...` examples, and add an explicit
    "do not invent flags for required args" rule to the argument
    conventions. Empirically verified across 6 hold-out scenarios that
    white-paper subagents now build correct invocations in one shot.
2026-04-29 Tidy C5–C13 reference and value placement
    Re-place Reference and Value properties for C5/C12/C11 (top row) and
    C6/C14/C13 (bottom row) using one consistent rule per row: Reference
    horizontal centered on body in the strip between body and pin corner,
    Value vertical cascaded outward at each cap's pin-extension end. Cuts
    inspect score 30092.8 → 13691.3 with ERC and netlist parity.
    [rx-power.kicad_sch]
2026-04-29 Add VOUT TVS clamp
    [initial-bom.csv, rx-power.kicad_sch]
2026-04-29 Eliminate C5-C14 ref/value collisions
    Shift each Reference (C5/C6/C11/C12/C13/C14) +2.54 mm in X off
    body_x so its bbox no longer overlaps the symbol's pin "2" character.
    Re-cascade top-row Values (C5/C12/C11) outward to clear the rail wire
    at y=76.2 mm. Inspect score 13716.3 → 7524.5; C5-C14 collision count
    7 → 0 with ERC and netlist parity.
    [rx-power.kicad_sch]
2026-04-29 Document bring-up constraints
    [initial-bom.csv]
2026-04-29 Tighten Z1/Z2/L1/C1 label placement on rx-power
    Reposition Reference and Value properties for L1, C1, Z1, Z2 so each
    label sits snug to its symbol body while clearing wires, pins, and
    neighboring component bodies. C15 is unchanged. Z1/Z2 Value collisions
    (wire@x=85.09, pin-1 text@(72.136,122.555)) eliminated. Inspect score
    7524.5 → 5594.0 with ERC and netlist parity; remaining 4 collisions
    (U1 Value, C9 Value, I2C_SDA, I2C_SCL) are outside this scope.
    [rx-power.kicad_sch]
2026-04-29 Manual cleanup pass on rx-power and sensors-logic sheets
    [rx-power.kicad_sch, sensors-logic.kicad_sch]
2026-04-29 Document validate/inspect JSON nesting in kicad-tool SKILL
    Add a Validate JSON section spelling out the {erc, netlist, inspect}
    wrapper, and rewrite the Inspect JSON score bullet to clarify score is
    a nested object with sub-fields (total, collision_count, ...). Prior
    wording let readers reach for d["score"] or d["inspect"]["collision_count"]
    and hit KeyError; verified the new wording empirically with fresh
    subagents.
2026-04-29 Relax sch inspect: skip benign global_label/property overlaps
    A global_label whose anchor sits on a pin endpoint unavoidably
    clips that pin segment — this is correct topology, not a collision,
    so stop counting it. Also skip the symbol-bbox hit when a property
    text sits inside its own symbol body (IC bbox interiors are empty,
    so the text remains readable).
    [kicad_sch_bbox_collisions.py]
2026-04-29 Lift C4 100nF value off horizontal wire on rx-power
    C4's vertical Value text bbox clipped the horizontal wire at y=132.08
    by ~0.15 mm. Shift anchor up to (193.04, 127.5) so the text clears
    the wire entirely. Last remaining real collision on this sheet.
    [rx-power.kicad_sch]
2026-04-29 Document heater harness footprint
    [initial-bom.csv]
2026-04-29 Penalize text crossing symbol body border in sch inspect
    Property text fully inside its own symbol body (e.g. IC interior) stays
    exempt, but text crossing the body outline now counts as a component_hit.
    Catches cases like C9's "10uF" Value sitting on top of a passive's body
    and pin numbers, which previously slipped through.
    [kicad_sch_bbox_collisions.py]
2026-04-29 Unify C9 label placement with R4 on rx-power
    C9's Reference and Value were on opposite sides versus R4's, making the
    two adjacent passives look mismatched. Mirror R4's offsets onto C9 so
    both have Reference left, Value right, vertical orientation. Resolves
    the C9 Value/body border collision found by the new sch-inspect rule.
    [rx-power.kicad_sch]
2026-04-30 Add Phase 2 placement geometry recipe to kicad-sch-cleanup-loop
    Captures the probe-then-arithmetic procedure for tightening label/value
    placement: render and read the PNG first, probe once for the actual bbox
    and four asymmetric anchor offsets, then derive the final position by
    clearance arithmetic. Names `sch query region` as the canonical source
    for graphic body bbox and warns off `sch inspect`'s component_hits bbox
    which can include attached property text.
2026-05-01 Update design notes and sheet annotations for v1 decisions
    - design-notes: record cup contact layer choice (alumina-filled silicone
    pad) and close out LED-2/INTB indicator decision (D2 driven from
    RX_VAA -> R11 -> GPIO0; INTB exposed via J3 only, no LED driver)
    - cupwarmer-hw root sheet: refresh key global labels annotation
    - sensors-logic: reword "first spin" -> "v1" for consistency
    - rx-power: nudge R10 down 1.27mm to clear surrounding labels
    [cupwarmer-hw.kicad_sch, rx-power.kicad_sch, sensors-logic.kicad_sch]
2026-05-02 Add v1 PCB floorplan and thermal bring-up notes
    [cupwarmer-hw.kicad_pcb, heater-control.kicad_sch]
2026-05-02 Prepare v1 PCB placement planning
    [heater-control.kicad_sch, initial-bom.csv, rx-power.kicad_sch, sensors-logic.kicad_sch]
2026-05-03 Add read-only PCB CLI commands to kicad-tool
    Implements Milestone 1 of the PCB CLI plan: pcb query
    list/footprint/pad/net/region and pcb render-region with a default
    agent-inspection layer set. pcb drc is unchanged. Net lookup resolves
    REF.PAD only when both ref and pad exist on the board, so dotted net
    names are not misparsed.
2026-05-03 Add safe footprint placement edits to PCB CLI
    Implements Milestone 2 of the PCB CLI plan: pcb edit footprint
    move / move-property / move-layer. Edits are minimal text-anchored
    S-expression patches over the .kicad_pcb (no kiutils write
    round-trip), preserving formatting and UUIDs. Each command supports
    --dry-run with a unified diff and refuses locked footprints. The
    move-layer flip swaps F.*/B.* layers and Y-mirrors internal geometry
    while keeping the footprint origin fixed, so a front->back->front
    round-trip is byte-identical.
2026-05-03 Add PCB import-footprints and full board validate to kicad-tool
    Implements Milestone 3 of the PCB CLI plan. pcb import-footprints
    diffs the schematic netlist against the board, splices any missing
    footprints into the .kicad_pcb at deterministic staging coordinates
    (5 mm grid at 200,200 mm, alphanumeric ref order), and never touches
    existing footprint blocks; --output writes elsewhere without
    modifying the input board, --dry-run writes nothing. pcb validate
    runs PCB DRC plus a refs+footprint-lib-id parity check against the
    top-level schematic, distinguishes a DRC process crash or missing
    report from a clean run, and supports --save-baseline / --baseline
    for diffing against a known-good snapsh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
2026-05-04 Fix correctness bugs in PCB CLI footprint, layer, and DRC handling
    Post-review fixes across the PCB CLI helpers:
    pcb_query.py
    - _fp_to_abs now mirrors local Y for back-side (B.*) footprints
    before rotation, so pad and bbox absolute coordinates match KiCad.
    pcb_edit.py
    - move-layer no longer rewrites layer tokens via global string
    substitution; F./B. swaps are scoped to (layer ...) and
    (layers ...) S-expressions and the layers body is extracted with
    depth tracking, leaving string literals and property values alone.
    - Layer flip mirrors only geometry subforms (fp_line, fp_arc,
    fp_circle, fp_poly, fp_rect, pad); property and fp_text (at)
    values are preserved, matching KiCad's own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
2026-05-04 Document PCB CLI commands in kicad-tool SKILL.md
    Adds the new pcb subcommands (validate, render-region,
    import-footprints, query, edit footprint) to the skill reference so
    agents see the full command surface, not just pcb drc.
2026-05-04 Add jlcpcb-parts skill for searching the LCSC catalogue
    Builds a local SQLite from yaqwsx/jlcparts's published JSON shards
    (~100MB DL, refreshed every ~6h upstream) and serves a CLI for MPN /
    parametric / category search with LCSC# lookup. Hardened per dual-review:
    deterministic SQL ORDER BY, unit-family-safe attr ops, LIKE wildcard
    escape, atomic build with lock + failed-shard threshold, manifest
    short-circuit on update.
2026-05-04 Add --text-fallback to jlcpcb-parts search
    When upstream's parser mis-routes MPN tokens into the wrong attribute
    key (e.g. TORCH CT41G's "2X1" segment ends up in "Temperature
    coefficient"), parametric --attr filters silently miss otherwise valid
    parts. With --text-fallback, a 0-hit attr search retries by substring-
    matching the attr values against MPN/description, with a stderr notice.
2026-05-04 Align cupwarmer BOM with STEVAL-WLC38RX reference (JLCPCB-orderable)
    - Pick concrete JLCPCB MPNs for all TBD parts in initial-bom.csv:
    - Cs (5x 100nF) and 100nF bypass roles → Wuerth 885012206095 (C6715111),
    matching STEVAL exactly.
    - 10uF rectifier/output bulk → Murata GRM188R6YA106MA73D (C194427).
    - 4.7uF VAA → Murata GRM188R61E475KE11D (C90057).
    - Add VRECT/VOUT bulk + HF + Z4 SMBJ18A clamp per STEVAL UM3154.
    - Other passives: Samsung MLCC, UNI-ROYAL 0603 1% resistors,
    KEXIN 10k NTC, SMF13A/SMBJ15A TVS, AO3400, KSD9700-70.
    - Add `lcsc` column to BOM CSV; mark mechanical/board-feature rows.
    - Sync MPN/LCSC/Manufacturer properties onto every schematic symbol via
    tm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
    [cupwarmer-hw.kicad_pcb, heater-control.kicad_sch, initial-bom.csv, rx-power.kicad_sch, sensors-logic.kicad_sch]
2026-05-04 Clean up VRECT/VOUT cap-bank labels on rx-power
    Right-side cap bank had 17 schematic collisions (12 property-property
    text overlaps in midgaps + 5 SYS_GND globals stacked at the same y
    overlapping each other).
    - VRECT row: replace 5 per-cap GND drops with a single horizontal rail
    at y=99.06 + one SYS_GND label, plus T-junctions on each cap pin2.
    - Cap+TVS Reference labels (C9/C20/C21/C22/Z4 and C2/C23/C24/Z3/R10)
    moved to horizontal placement above (VRECT) / below (VOUT) the row.
    - Z4 and R10 Value labels shifted off the midgap to free the
    C22-Z4 / C24-R10 corridors.
    - C2.Reference offset off the GND-stub x; R10.Reference offset right
    to clear pin-1 label and D1 body.
    Score 25281 -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
    [rx-power.kicad_sch]
2026-05-04 Normalize VRECT/VOUT bulk cap values on rx-power
    C20/C21/C2/C23 had "10uF/25V" while C9 was "10uF" — drop the voltage
    suffix so all bulk caps display as "10uF" and bypass caps as "100nF".
    Voltage rating is tracked in the BOM (Murata GRM188R6YA106MA73D, 35V).
    ERC 0.
    [rx-power.kicad_sch]
2026-05-04 Add bird's-eye three-zoom self-check to KiCad editing skills
    Prepend a Board/Sheet/Local (or Area) framing pass before plan
    approval and cluster planning, so scope and alternative framings
    get surfaced before mechanical edits begin.
2026-05-04 Update heater to 12 ohm/12W spec and sync rx-power labels + PCB
    - BOM: H1 heater spec from 15 ohm to 12 ohm (12W @ 12V, 1A target)
    - rx-power.kicad_sch: tidy R5/R6/R10 reference/value label positions
    - cupwarmer-hw.kicad_pcb: sync footprint set to current schematic
    [cupwarmer-hw.kicad_pcb, initial-bom.csv, rx-power.kicad_sch]
2026-05-04 Apply ST UM3154 review fixes to Qi RX schematic
    Address tape-out blockers from STEVAL-WLC38RX (UM3154) reference diff:
    - Add R12 (10k) INTB pullup to RX_VAA on rx-power
    - Add R13 (10k) ENB pulldown to SYS_GND on rx-power
    (replaces direct ENB->GND tie; matches ST eval, allows future MCU control)
    - C18, C19 value 100nF -> 10nF (NP0) on rx-power
    (Cs=320nF total with 8uH coil targets ~99.5kHz Qi resonance vs prior 79.6kHz)
    - Replace TH2 with Murata NCP18WF104F12RB 100k B25/85=4260K on sensors-logic
    (matches ST eval reference 100k NTC; aligns with default HOTP threshold)
    - Remove TH1 + R8 + J2 (THERM_MON) and NTC_TOP labels from sensors-logic
    (redundant; KSD9700 + STWLC38 HOTP via TH2 al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
    [heater-control.kicad_sch, initial-bom.csv, rx-power.kicad_sch, sensors-logic.kicad_sch]
2026-05-04 Merge sensors-logic into rx-power; delete sensors-logic sheet
    sensors-logic had only 3 symbols left after the THERM_MON cleanup
    (J1 I2C service header, J3 status header, TH2 100k NTC).
    Move them into rx-power and remove the sub-sheet.
    - rx-power.kicad_sch: add J1 (152.4, 170.18), J3 (152.4, 185.42),
    TH2 (76.2, 175.26) with their global labels (RX_VAA, SYS_GND,
    I2C_SCL, I2C_SDA, RX_INTB, RX_NTC, I_HEATER_MON) preserved
    - cupwarmer-hw.kicad_sch: remove sensors-logic sheet block
    - delete sensors-logic.kicad_sch and sensors-logic.kicad_prl
    ERC: 0 errors, 0 warnings. Netlist node membership unchanged
    (verified via kicad-tool sch validate baseline diff).
    PCB intentionally not updated; sync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
    [cupwarmer-hw.kicad_sch, rx-power.kicad_sch, sensors-logic.kicad_sch]
2026-05-04 Tidy rx-power schematic layout
    Manual cleanup of rx-power.kicad_sch after the sensors-logic merge.
    Also drop the stale sensors-logic entry from cupwarmer-hw.kicad_pro
    sheet list.
    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
    [rx-power.kicad_sch]
2026-05-04 Switch L1/F1/H1 to no-relief SolderWire footprints
    Relief / Relief2x variants extend 13.8-27.6mm of strain-relief tail
    that conflicts with adjacent courtyards on the phi76mm board. For
    hand-soldering with enclosure-side wire fixation, plain 2-pad THT is
    sufficient.
    - sch (rx-power, heater-control): drop _Relief2x / _Relief suffix from
    L1, F1, H1 Footprint properties
    - pcb: re-import the three footprints from sch and reposition
    (L1 130,88 rot=90; F1 128,108; H1 122,120) to clear edge clearance
    and silk overlaps
    - BOM: L1 / F1 notes updated to reflect no-relief land + enclosure
    strain-relief assumption
    DRC: 195 -> 171 violations; no functional errors on L1/F1/H1 (only
    benign lib_foot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
    [cupwarmer-hw.kicad_pcb, heater-control.kicad_sch, initial-bom.csv, rx-power.kicad_sch]
2026-05-04 Add `sch edit symbol delete` and `set-property` to kicad-tool
    Two missing write operations forced subagents to fall back to raw
    Edit on .kicad_sch S-expressions. Plug those gaps so they don't.
    - sch_edit.py: delete_symbol() removes a symbol block by reference
    (mirrors delete_wire pattern via _expand_block_with_indent), and
    reports connected wire/label/junction taps within 0.01mm of pins
    as warnings — does not auto-cleanup attached nets
    - sch_edit.py: set_symbol_property() updates any property value
    (Reference/Value/Footprint/Datasheet/Description plus user-defined
    MPN/LCSC/Manufacturer/...). Raises with available-keys list when
    the key is missing
    - kicad_tool.py: argparse subp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
2026-05-04 kicad-tool: rewrite description to suppress raw .kicad_sch edits
    Subagents kept falling back to Read/cat/grep/Edit on .kicad_sch
    S-expressions instead of using `sch query` / `sch edit`. The old
    description led with "schematic rendering, visual inspection..."
    which read as a niche tool, not the single owner of all KiCad
    file I/O.
    - frontmatter description: lead with the prohibition (no raw
    Read/cat/grep/Edit on .kicad_sch / .kicad_pcb / .kicad_pro) and
    enumerate the concrete questions/edits the CLI handles, so the
    trigger language matches subagent intent ("what is REF connected
    to", "set Value/MPN/LCSC", "delete a symbol")
    - new "When to use" body section: bullet lists mapping common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
2026-05-04 Shrink board outline to phi56mm (enclosure phi60mm)
    Cup-bottom diameter measured at ~60mm on the target ceramic mugs, so
    constrain enclosure outer diameter to phi60mm and PCB outer diameter
    to phi56mm (1.5-2mm wall budget). Components-under-coil layout is
    allowed since the rim is only 10.5mm wide and cannot hold U1 +
    passives + F1/H1/L1 lands together.
    - design-notes: add phi60mm enclosure / phi56mm PCB rule with the
    components-under-coil rationale; supersede earlier "outer diameter
    ~90mm" placeholder
    - pcb: scale the 32 Edge.Cuts segments uniformly from r=38 to r=28
    around (100,100); delete stale "V1 FLOORPLAN / 76mm circular
    placeholder" gr_text plus the phi72/phi68 reference circ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
    [cupwarmer-hw.kicad_pcb]
2026-05-05 Place all 50 footprints inside phi56mm board (zero-base v1 layout)
    Re-laid all components from scratch using STEVAL-WLC38RX UM3154 p.45
    reference and the U1 WLCSP-40 pin map confirmed via sch query: AC2 at
    col 1-2 (west), AC1 at col 4-5 (east), VRECT D row, VOUT/COMA/COMB/NTC
    on west-side cols, VAA/VDD/I2C on east-side cols. U1 oriented rot=0 at
    (100, 90) so AC pair faces L1 north, VRECT/VAA/VDD/I2C exit east, and
    VOUT/ASK exit west.
    Cluster layout (mm, center 100,100):
    - A: U1 inner ring Z1/Z2 ESD C5/C6 BOOT C15 parallel cap
    - B: north (y=80-83) L1 wire pad + 5 resonant caps C1/C16-19 + R4 IEXT
    - C: east (x=104-114) VRECT bulk C9/C20-22 + VAA/VDD C7/C8/C4 +
    I2C/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
    [cupwarmer-hw.kicad_pcb]
2026-05-05 Clean up R12/R13 stack and labels in rx-power sheet
    Resolve body overlaps and label collisions around R12/R13 by shifting
    R12 right by 2.54mm and adjusting global label rotation/justify so
    visual direction points away from symbol bodies.
    [rx-power.kicad_sch]
2026-05-05 Remove TH1 footprint from PCB
    TH1 was deleted from the schematic; reflect it on the PCB.
    NTC_TOP off-board sensing is dropped — TH2 (RX_NTC for STWLC38
    internal OTP) remains the only thermistor.
    [cupwarmer-hw.kicad_pcb]
2026-05-05 Switch L1 to Würth 760308102207 (WE-WPCC 8 µH)
    AN5961 Table 1 L4 reference coil with published DCR/ACR
    (60 mΩ typ vs YX-A11 unspecified). Mouser/Digi-Key stocked,
    40×40×1.2 mm rounded-square fits within the φ56 mm PCB.
    YX-A11 retained as measurement-comparison candidate.
    [initial-bom.csv]
2026-05-05 Auto-derive global label justify from --rotation in kicad-tool
    `sch edit label add/move --rotation` now sets `(justify left|right)` to
    match KiCad's R-key cycle (0/90 → left, 180/270 → right) for passive
    global labels, so a single rotation arg covers all four directions.
    Drops the unused `--justify` flag.
2026-05-05 Add `pcb edit footprint delete` to kicad-tool
    Needed to remove C15 footprint from cupwarmer-hw.kicad_pcb after
    deleting the Cd symbol from the schematic.
2026-05-05 Drop Cd (C15) parallel resonant cap
    UM3154 §9.1.2 documents Cd as optional, used only for Qi-cert
    backward compatibility with specific TX coils. cupwarmer is not
    pursuing Qi certification, so the cap adds drift and loss without
    benefit. Removed C15 (3.3 nF NP0 / Walsin 0603N332J500CT) from
    the rx-power schematic, the PCB, and the BOM. Decision recorded
    in docs/design-notes.md.
    ERC clean; sch↔board parity unchanged otherwise.
    [cupwarmer-hw.kicad_pcb, initial-bom.csv, rx-power.kicad_sch]
2026-05-05 Switch L1 footprint to Würth 760308102207 (P5.0mm)
    Custom SolderWire footprint with 5.0mm pitch and φ1.2mm holes
    matching the WE-WPCC 760308102207 lead pattern. Includes a
    40×40mm rounded-square outline on Dwgs.User as a placement guide
    for the coil module body. Schematic L1 properties (Value, MPN,
    Manufacturer, LCSC, Footprint) updated to match the BOM.
    ERC clean; PCB parity unchanged; no new DRC violations on L1.
    [cupwarmer-hw.kicad_pcb, rx-power.kicad_sch]
2026-05-05 Actually drop C15 (Cd) symbol + footprint
    Earlier 522ecc1 commit removed the BOM row but the kicad-tool
    delete on the schematic silently no-op'd, leaving C15 in
    rx-power.kicad_sch and the PCB. This commit deletes the symbol,
    its two dangling wire stubs, and the footprint. ERC clean.
    [cupwarmer-hw.kicad_pcb, rx-power.kicad_sch]
2026-05-05 Record Cs dielectric decision: C0G 0805 multi-parallel
    cup warmer is in continuous warm operation (heater H1 + coil losses), so
    X7R temperature drift (+/-15%) plus DC bias capacitance loss would shift
    the AC1/AC2 series resonance and degrade efficiency / VRECT regulation.
    C0G (NP0) is required.
    Smaller-is-better, but 100nF/50V C0G in 0603 does not exist as a standard
    stock part (C0G volumetric efficiency caps 0603 50V at ~22nF). Derating
    to 25V to fit 0603 is unsafe given AC1/AC2 differential swing, so 0805
    C0G multi-parallel is the practical choice -- also matches UM3154 9.1.2.
    Affects C1/C16/C17 only (Cs primary 3x100nF X7R 0603 -> C0G 0805).
    C18/C19 (10nF NP0 0603) stay as-is. sch/BOM/P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
2026-05-05 Make sch wire/junction delete UUID-only
    Drops `--from`/`--to` from `sch edit wire delete` and `--at` from
    `sch edit junction delete`. Endpoint matching was fragile (split wires
    across an intermediate junction miss) and the UUID is already surfaced
    by `sch query wire`/`region` and the corresponding `add` return values.
2026-05-05 Swap Cs primary caps to C0G 1206 (3x100nF GRM31C5C1H104JA01L)
    C1/C16/C17 were 100nF/50V X7R 0603 (Würth 885012206095). cup warmer is
    in continuous warm operation (heater H1 + coil losses), so the X7R
    temperature drift (+/-15%) plus DC bias capacitance loss would shift
    the AC series resonance and degrade efficiency / VRECT regulation.
    C0G (NP0, +/-30 ppm/degC, no DC-bias drop) is required.
    JLC DB confirmed 100nF/50V C0G is unavailable in 0603 and 0805
    (C0G volumetric efficiency caps 0805 50V at ~33nF). 1206 is the
    smallest stocked size for 100nF/50V C0G; 3x1206 (15.4 mm^2) beats
    14x22nF/0805 (35 mm^2) on total board area, so going up in package
    size for fewer parts is the right trade-off he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
    [cupwarmer-hw.kicad_pcb, initial-bom.csv, rx-power.kicad_sch]
2026-05-05 Add `pcb edit footprint set-property` to kicad-tool
    Mirrors the existing `sch edit symbol set-property` op for `.kicad_pcb`
    files. Rewrites a single property's quoted value inside one footprint
    block (Value, Description, MPN, LCSC, etc.) while preserving the
    sub-forms `(at ...)`, `(layer ...)`, `(uuid ...)`, `(effects ...)`.
    Raises if the property key does not exist (no silent insertion) and
    refuses locked footprints, matching `move_footprint_property`.
    Needed to sync stale PCB silk Value strings to schematic without
    falling back to raw .kicad_pcb edits (e.g. TH2 "NTC 10k B3950" →
    "NTC 100k B4250"; later C18/C19/C2/C9/C20/C21/C23 silk fixes per
    UM3154 §9 board-fixes plan).
    Co-Authored-B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
2026-05-05 Sync TH2 silk Value to 100k NCP18WF104F12RB
    PCB silk on TH2 read "NTC 10k B3950" — drift from an earlier candidate
    that was never reflected in sch/BOM. STWLC38 NTC RX_NTC reference per
    UM3154 §9.1.7 (and STEVAL-WLC38RX BOM) is R7=10k pull-up + TH2=100k
    NCP18WF104F12RB B25/85=4250K, which is what sch and BOM have already.
    silk-only fix; no schematic, BOM, or net change.
    trip-temperature numerical sizing (R7 vs NTC value vs default 0x40
    threshold) is deferred to Phase 1.4 (NTC divider redesign) of
    docs/plans/20260505-um3154-section9-board-fixes.md.
    [cupwarmer-hw.kicad_pcb]
2026-05-05 Set STWLC38 NTC pull-up to 51k
    [cupwarmer-hw.kicad_pcb, initial-bom.csv, rx-power.kicad_sch]
2026-05-05 Sync PCB values and remove unused monitor footprints
    [cupwarmer-hw.kicad_pcb]
2026-05-05 Add parallel SOVP clamp resistors
    [cupwarmer-hw.kicad_pcb, initial-bom.csv, rx-power.kicad_sch]
2026-05-05 Change power indicator LED to red
    [cupwarmer-hw.kicad_pcb, initial-bom.csv, rx-power.kicad_sch]
2026-05-05 Add PCB layer list query
2026-05-05 Resync PCB from schematic and tighten ERC
    Re-import netlist and reflow the board to match the current schematic
    (sense resistor R3 0R/0.05R bring-up option, refreshed footprints and
    UUIDs). Promote ERC pin_to_pin from warning to error and drop stale
    diff_pair_via_gap settings. Ignore generated *.net netlist exports.
    [cupwarmer-hw.kicad_pcb]
2026-05-05 kicad-tool: text default + on-error usage hint
    Switch every kicad-tool subcommand's --format default from json to text
    and emit a text summary for sch/pcb queries (with JSON fallback for
    unhandled keys). On runtime failure (FileNotFoundError, ValueError,
    KeyError, LookupError) print the offending subcommand's usage to stderr
    so callers stop chasing --help in a separate roundtrip.
    Also reject Reference in `pcb edit footprint set-property` — Reference
    must flow through the schematic + `pcb import-footprints`, not direct
    board edits.
2026-05-05 kicad-tool: pin kiutils via requirements, drop local sys.path hack
    Replace the hard-coded `/Users/mash/src/github.com/mvnmgrx/kiutils/src`
    sys.path inserts in every script with a pinned pip dependency on the
    mash/kiutils fork at commit 77994e0 (KiCad 10 `(net "name")` parsing
    fix). Scripts now resolve kiutils through the normal import path; setup
    is `pip install -r .agents/skills/kicad-tool/requirements.txt`.
    [kicad_sch_bbox_collisions.py, score_schematic.py]
2026-05-05 kicad-tool: resolve paths against CWD for plugin compatibility
    `SCRIPT_DIR.parents[3]` happened to point at the cupwarmer repo root only
    because of the `.agents/skills/kicad-tool/scripts/` layout. When the same
    script is installed as part of the kicad-skills Claude Code plugin, it
    lives outside the user's project tree and `parents[3]` becomes the plugin
    install dir, breaking every `cwd=REPO_ROOT` subprocess. Use `Path.cwd()`
    instead so relative paths resolve against the caller's working directory
    in both the in-tree and plugin-install layouts.
2026-05-05 Migrate KiCad skills to kicad-skills plugin
    Drop the in-tree copies of `kicad-tool`, `kicad-validate`,
    `kicad-hardware-editing`, and `kicad-sch-cleanup-loop` from
    `.agents/skills/` now that the same skills are provided by the
    `kicad-skills` Claude Code plugin (registered as a local marketplace at
    `/Users/mash/src/github.com/mash/kicad-skills`).
    The plugin merges `kicad-validate` + `kicad-hardware-editing` into a
    single `kicad-workflow` skill, so update `electronics-design-principles`
    references accordingly. Repo-local skills (`electronics-design-principles`,
    `jlcpcb-parts`) stay in-tree per the plugin's project-agnostic scope.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
2026-05-05 Enable kicad-skills plugin in project settings
2026-05-05 Lock 4-layer stackup to SIG/GND/GND/SIG
    VOUT_12V は単一 rail・0.8A のため内層 power plane を不採用とし、L2/L3
    を両方 solid SYS_GND にする方針を hardware/pcb/README.md に反映。
    AC1/AC2 と WLCSP40 escape の return 整合を最優先する。詳細プランは
    docs/plans/20260505-4layer-stackup-inner-layers.md (gitignore 配下)。
2026-05-05 Pour SYS_GND on inner layers and label rx-power nets
    - PCB: add SYS_GND zones on In1.Cu/In2.Cu, add GND stitching vias,
    reflow footprint placement
    - rx-power.sch: label AC1/2, COMA1/2, COMB1/2, BOOT1/2, VRECT nets
    - heater-control.sch: nudge KSD9700 value label
    - project: housekeeping from KiCad open
    [cupwarmer-hw.kicad_pcb, heater-control.kicad_sch, rx-power.kicad_sch]
2026-05-05 Assign netclasses and unblock U1 routing
    - kicad_pro: assign POWER (VOUT_12V, VRECT, RX_VAA, RX_VDD, SYS_GND,
    AC1, AC2) and SENSE (BOOT1/2, COMA1/2, COMB1/2); add 0.2mm to
    pre-defined track widths
    - pcb: U1 local pad clearance override 0.13mm so 0.4mm-pitch WLCSP
    pads stop reporting clearance violations against each other; add
    initial AC1/VRECT/SYS_GND track segments
    - rx-power.sch: label coil-side AC1 net ("AC1 COIL")
    [cupwarmer-hw.kicad_pcb, rx-power.kicad_sch]
2026-05-05 Route U1 area and tighten board design rules
    Reposition rx-power footprints around U1, add LED2 label on
    rx-power.kicad_sch, drop min_hole_clearance to 0.1mm, add a 0.13/0.1mm
    via size and a 0.1mm track width, and add a custom DRU rule allowing
    zero clearance inside U1's courtyard so dense routing under the IC
    passes DRC.
    [cupwarmer-hw.kicad_pcb, rx-power.kicad_sch]
2026-05-06 Reposition U1 quiet-side passives and rework SYS_GND stitching
    Move TH2, R7, R13, C4 (VDD HF) and reroute the surrounding SYS_GND
    segments so the NTC/I2C/VDD-bypass cluster sits in U1's east quiet
    quadrant without overlapping the VRECT/VOUT bulk paths.
    [cupwarmer-hw.kicad_pcb]
2026-05-06 Adopt JLCPCB DRC ruleset in kicad_dru
    Replace the single U1 courtyard clearance override with the standard
    JLCPCB 4-6 layer DRC rule pack (hole sizes, annular ring, hole-to-hole,
    trace width/spacing on outer/inner, silkscreen, edge clearance) so DRC
    matches the fab's actual capability instead of KiCad defaults.
2026-05-06 Add U1 BGA escape DRC rules and tighten breakout passive placement
    Extend kicad_dru with JLCPCB 4-layer BGA-guide limits scoped to U1's
    courtyard (0.09mm trace width / clearance, 0.10mm BGA pad-to-trace
    and via-to-BGA-pad, 0.14mm via hole edge-to-trace, 0.25mm BGA pad
    and via copper, 0.05mm via annular ring) while keeping the rest of
    the board on the conservative JLCPCB 4-6 layer ruleset. Drop the
    4-wire Kelvin avoidance rule since the WLCSP40 fanout requires
    0.15/0.25mm vias.
    Update kicad_pro to provide a 0.25/0.15mm via stack and a 0.076mm
    predefined track width for BGA escape, and reposition U1 breakout
    passives, fanout vias, and SYS_GND stitch tracks to match the new
    escape pattern.
    Co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
    [cupwarmer-hw.kicad_pcb]
2026-05-06 Tidy U1 silkscreen and nudge breakout passives
    Reposition reference designators around the U1 BGA fanout so silk
    labels stop colliding with adjacent footprints, and nudge a few
    breakout passives by ~0.4mm to make room for the relabeled silk.
    Adds a handful of routing segments incidental to the moves.
    [cupwarmer-hw.kicad_pcb]
2026-05-06 Ignore KiCad auto-backup zips for cupwarmer-hw
2026-05-06 Nudge Cs/COM passive row and minor track adjustments
    Shift the C16/C17/C1/C18/C19-side passive row by 0.5mm to align with
    the AC1/AC2 fanout, slide a few breakout-area parts by ~0.3mm, and
    clean up four short routing segments around U1.
    [cupwarmer-hw.kicad_pcb]
2026-05-06 Reposition U1 passives and add hole-to-hole DRC exclusions
    Rotate and shift the COMA/COMB and Cs decoupling caps around U1, nudge
    several breakout passives, and exclude a cluster of hole-to-hole DRC
    violations under U1's BGA escape area where via spacing is intentional.
    [cupwarmer-hw.kicad_pcb]
2026-05-06 Rework SYS_GND segments around U1 and refresh DRC exclusions
    Replace the SYS_GND stub routing under U1 with cleaner short segments,
    nudge a couple of breakout pads, and refresh the hole-to-hole DRC
    exclusion list to match the new via positions.
    [cupwarmer-hw.kicad_pcb]
2026-05-06 Replace coil/ferrite notes with BGA via fab note
    Drop the placeholder "NO LARGE METAL OVER COIL CORE" and "FERRITE /
    MECH ENVELOPE TBD" notes and add a Cmts.User note specifying that U1
    BGA escape vias (0.15mm drill / 0.25mm dia) must be epoxy-filled and
    copper-capped, with no open vias on BGA pads. Reposition the title
    block.
    [cupwarmer-hw.kicad_pcb]
2026-05-06 Tag HEATER_IN/OUT as POWER and refresh DRC exclusions
    Add HEATER_IN/HEATER_OUT labels in heater-control and assign them to
    the POWER netclass. Refresh hole_to_hole DRC exclusions after the
    recent PCB rework.
    [cupwarmer-hw.kicad_pcb, heater-control.kicad_sch]
2026-05-06 Add U1 BGA via-to-via DRC rule and clear hole-to-hole exclusions
    Add a JLCPCB-style 0.25mm hole-to-hole rule scoped to U1 courtyard so
    the BGA escape via cluster passes DRC, drop the now-unneeded
    hole_to_hole exclusions, and tag I_HEATER_MON as POWER.
    [cupwarmer-hw.kicad_pcb]
2026-05-06 Add H2/H3/H4 M2 mounting holes and nudge nearby segments
    [cupwarmer-hw.kicad_pcb]
2026-05-06 Add NPTH keepouts and align mounting holes to library
    Add three circular rule_area keepouts (r=2.5mm, all Cu layers) under
    the H2/H3/H4 M2 mounting holes so SYS_GND backs off from the screw
    heads/standoffs. Rewrite H2/H3/H4 footprint bodies to match the
    KiCad MountingHole_2.2mm_M2 library (correct descr/tags, version
    and generator, KiLib_Generator property, Cmts.User and F.CrtYd
    outline circles, F.Fab reference text, library reference/value
    offsets, no extra Datasheet/Description blocks). Pads remain
    2.2mm/2.2mm NPTH; copper clearance is now provided by the
    keepouts. DRC clean (0 violations).
    [cupwarmer-hw.kicad_pcb]
2026-05-06 Document ferrite sheet sourcing
    [initial-bom.csv]
2026-05-09 Add heater harness NTC routing
    [cupwarmer-hw.kicad_pcb, cupwarmer-hw.kicad_sch, heater-control.kicad_sch, initial-bom.csv, rx-power.kicad_sch]
2026-05-09 Move F1 thermostat and TH2 NTC off-board
    F1 (KSD9700 thermostat) and TH2 (heater NTC) are now part of the
    heater assembly rather than the cupwarmer PCB; they ship together
    with the JLCPCB silicone heater order. Drop F1's PCB footprint,
    flip the schematic symbol to on_board=no, and add TH2 to the BOM
    as an off-board NTC. Document R7=51k sizing for the OTP divider.
    [cupwarmer-hw.kicad_pcb, heater-control.kicad_sch, initial-bom.csv]
2026-05-09 Add JLCPCB flexible heater Gerber project
    KiCad project and Gerber package for the external 56 mm flexible
    heater. The Gerber defines the circular outline, four lead-out pads
    (H+, H-, NTC, NTC_GND) and a center NTC marker; JLCPCB routes the
    FeCrAl heating element to hit the 12 V / 12 W / 12 ohm target during
    engineering review.
    [heater.kicad_pcb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]
2026-05-09 Resize heater NTC pads to standard 0603 land
    JLCPCB flexible heater "Solder NTC" requires reserved pads. Shrink the
    center NTC footprint from a generic 1.5x2 mm pair at 2.5 mm pitch to a
    standard 0603 reflow land (0.9x1.0 mm at 1.65 mm pitch) so JLC can
    solder a 0603 NTC at the heater center. Regenerate the Gerber zip.
    [heater.kicad_pcb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]
2026-05-09 Lay out H1 heater harness as 1x4 inline connector
    Redraw HEATER_HARNESS_4 symbol as a horizontal 1x4 with pins ordered
    H+, NTC, NTC_GND, H- to match the heater harness physical lead
    sequence for hand-soldering. Renumber pins (1=H+, 2=NTC, 3=NTC_GND,
    4=H-) and rebuild the footprint as an inline 4-pad row at 5 mm pitch
    with 1.4 mm holes for H+/H- and 1.0 mm holes for the NTC pair.
    Schematic ERC clean; PCB H1 needs Update-from-Schematic to relink
    nets and reposition.
    [cupwarmer-hw.kicad_pcb, heater-control.kicad_sch]
2026-05-09 Tidy heater-control sheet layout
    Drop collisions to 0 by relocating H1 + TP1/TP2 into a separate
    block, lengthening pin stubs so HEATER_IN/RX_NTC/SYS_GND/HEATER_OUT
    labels clear the H1 symbol body, and merging TP2 into the existing
    SYS_GND rail. ERC parity preserved; total score 6476 to 2525.
    [heater-control.kicad_sch]
2026-05-09 Remove R7 from rx-power after move to heater-control
    R7 was relocated to the heater-control sheet in 7f9c5df; clean up
    the rx-power side by deleting the symbol, the now-unused junction
    and wire stub, and re-anchoring the RX_VAA / RX_NTC global labels.
    [heater-control.kicad_sch, rx-power.kicad_sch]
2026-05-09 Add TH2 NTC symbol to heater-control as off-board
    Represents the 100k B4260 NTC physically embedded in the H1 silicone
    heater harness. Symbol uses cupwarmer:PASSIVE_2 with on_board=no and
    empty Footprint so it is excluded from netlist/PCB while staying
    visible in the schematic. Pins tie to the existing RX_NTC and
    SYS_GND nets via global labels at the pin endpoints.
    [heater-control.kicad_sch]
2026-05-09 Add R_HTR off-board to model heater coil; relabel H1
    Pair TH2 with R_HTR (12 ohm, 12 W coil) so the heater assembly's
    internals (heater + NTC) are explicit on the schematic but excluded
    from the board (on_board=no, empty Footprint). H1's Value drops
    the redundant element description and now reads "4-pin heater
    harness connector" — H1 is just the connector boundary; the actual
    parts live in R_HTR and TH2.
    [heater-control.kicad_sch]
2026-05-09 Mark H2 off-board; relabel H1/H2 as PCB-side / heater-side
    Add H2 as the heater-side 4-pin connector, paired with H1 on the PCB
    side. H2/F1/TH2/R_HTR remain visible on the schematic for
    documentation of the heater assembly, but are excluded from the PCB
    netlist via on_board=no.
    [cupwarmer-hw.kicad_pcb, heater-control.kicad_sch]
2026-05-09 Replace J3 bring-up header with TP3 test pad on I_HEATER_MON
    Drop the dual-purpose 2-pin J3 (RX_INTB + I_HEATER_MON bring-up) and
    expose only I_HEATER_MON via a single-pin TP3 test pad matching
    TP1/TP2 (TESTPAD_1 symbol, 1x01 pin header footprint). RX_INTB stays
    internal to the U1.H4 ↔ R12.1 path with its label moved onto that
    net.
    [cupwarmer-hw.kicad_pcb, heater-control.kicad_sch, rx-power.kicad_sch]
2026-05-09 Refresh PCB footprint placements and TP1 land
    Re-place and rotate several footprints (R1/R2/R3/R5/R6/R7, J1, H1, Q1)
    to tidy reference text against the current layout, swap TP1 (TP_NTC)
    from an SMD test pad to a 1x01 pin-header land for probe access, and
    bump the default pad-mask drill/size in the project to 1.0/1.7 mm.
    [cupwarmer-hw.kicad_pcb]
2026-05-09 Add B.Cu SYS_GND pour and exclude H1/L1 wire pads from BOM/POS
    - Add SYS_GND zone to B.Cu (full board polygon, fill params matching
    In1.Cu/In2.Cu GND pours) so the back-side signal layer carries a GND
    plane for return currents and EMI shielding.
    - Mark H1 (heater harness) and L1 (Wuerth coil) as
    exclude_from_pos_files / exclude_from_bom in both the PCB instances
    and the cupwarmer.pretty library footprints. They are hand-soldered
    wire pads and should not appear in JLCPCB Pick&Place / BOM outputs.
    DRC: 0 violations / 0 unconnected after refill_zones.
    Plan: docs/plans/20260509-pcb-dual-review-fixes.md (Phase 2-1, 2-2, 3-2).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
    [cupwarmer-hw.kicad_pcb]
2026-05-09 Upgrade R3 shunt footprint from 0603 to 1206 for 0.05R bring-up
    Phase 3-3 of docs/plans/20260509-pcb-dual-review-fixes.md.
    R3 sits in the heater current path: 0R for production, 0.05R during
    bring-up to read I_HEATER_MON on a scope. At 1.4 A peak, 0.05R
    dissipates ~100 mW, which has zero margin in 0603 (1/10 W). 1206 gives
    4x derating and accommodates a dedicated current-sense part with a
    useful TC.
    - heater-control.kicad_sch: R3 footprint -> R_1206_3216Metric;
    production LCSC C17888 (1206W4F0000T5E, 0R 1206 Basic);
    Description annotates bring-up MPN FRM121WFR050TM (LCSC C7467249,
    1W 1206 +/-1% +/-50ppm) sourced from JLCPCB.
    - cupwarmer-hw.kicad_pcb: pcb sync swapped R3 to 1206 footp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
    [cupwarmer-hw.kicad_pcb, heater-control.kicad_sch]
2026-05-09 Add VAA high-frequency bypass capacitor
    [initial-bom.csv, rx-power.kicad_sch]
2026-05-09 Update PCB layout state
    add C25
    [cupwarmer-hw.kicad_pcb]
2026-05-11 Update UM3154 PCB layout state
    [cupwarmer-hw.kicad_pcb]
2026-05-16 Tighten RX clamp layout and thermal notes
    [cupwarmer-hw.kicad_pcb, initial-bom.csv]
2026-05-16 Add coil body placement guide
    [cupwarmer-hw.kicad_pcb]
2026-05-16 Lower heater gate divider voltage
    [cupwarmer-hw.kicad_pcb, heater-control.kicad_sch, initial-bom.csv]
2026-05-16 Document heater harness and LED decisions
    [initial-bom.csv]
2026-05-16 Add schematic mounting holes for board parity
    [cupwarmer-hw.kicad_sch]
2026-05-16 Remove unused status monitor header
    [initial-bom.csv]
2026-05-17 Expand Q1 drain thermal pour
    [cupwarmer-hw.kicad_pcb]
2026-05-17 Remove redundant NTC ground test point
    [cupwarmer-hw.kicad_pcb, heater-control.kicad_sch]
2026-05-17 Swap service I2C header pins
    [cupwarmer-hw.kicad_pcb, rx-power.kicad_sch]
2026-05-17 Increase coil ground isolation
    [cupwarmer-hw.kicad_pcb]
2026-05-17 Sync PCB from schematic via kicad-tool
    Apply kicad-tool pcb sync now that it matches KiCad GUI's
    'Update PCB from Schematic' for units / pinfunction / pintype /
    Datasheet+Description values / (attr ...) exclude flags.
    DRC clean, parity clean, idempotent on re-sync.
    [cupwarmer-hw.kicad_pcb]
2026-05-17 Fix LED polarity and heater flyback diode
    [cupwarmer-hw.kicad_pcb, heater-control.kicad_sch, initial-bom.csv, rx-power.kicad_sch]
2026-05-17 Fix D2 PCB orientation
    [cupwarmer-hw.kicad_pcb, rx-power.kicad_sch]
2026-05-17 Move AC TVS clamps closer to receiver IC
    [cupwarmer-hw.kicad_pcb]
2026-05-17 Apply pre-order dual review fixes
    Pre-order schematic/PCB review decisions from
    docs/plans/20260517-pre-order-review-issues.md:
    - R1 15k -> 12k (UNI-ROYAL C22790): Q1 VGS_normal 4.8V -> 5.45V
    with clamp-time VGS=11.09V still inside AO3400 +/-12V (margin 0.91V)
    - D3 = B5819W Schottky (SOD-123, C8598): heater flyback / freewheel
    between Q1.drain (anode) and VOUT_12V (cathode). New DIODE_2 symbol
    in cupwarmer.kicad_sym; D3 placed near H1 at (100, 126) F.Cu.
    Zone connection tracks still to be routed in KiCad GUI
    - R11 1k -> 100R (UNI-ROYAL C22775): GPIO0 LED Vf margin and
    reliable lighting at I ~= 3mA; document NVM-write-first bring-up
    procedure to avoid GPIO0 dragging during high-Z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
    [cupwarmer-hw.kicad_pcb, initial-bom.csv, rx-power.kicad_sch]
2026-05-17 Ignore KiCad *.bak auto-backup files
2026-05-17 Add fiducials, R4 thermal spacing, off-board parts checklist
    Continuation of docs/plans/20260517-pre-order-review-issues.md
    review pass:
    - FID1/FID2/FID3 (Mechanical:Fiducial + Fiducial_1mm_Mask3mm):
    near H3/H4/H5 mounting holes to satisfy WLCSP40 outsourced SMT
    alignment requirement. FID2 offset to (120, 117.5) because the
    HEATER_OUT zone occupied the original (112, 112) target.
    in_bom=false, on_board=true.
    - R4 moved (87, 110.4) -> (87, 109.2) for thermal separation from
    R14 (now 3.2mm center-to-center vs prior 2mm) during IEXT SOVP
    pulses.
    - design-notes: heater pigtail extraction direction constraint
    (must exit PCB perpendicular to edge, not loop around the board,
    to avo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
    [cupwarmer-hw.kicad_pcb, cupwarmer-hw.kicad_sch]
2026-05-17 Route D3 flyback and R15/R16 I2C series tracks
    Manual KiCad GUI routing to complete the pre-order review fixes:
    - D3 (B5819W flyback) pad1 -> VOUT_12V and pad2 -> HEATER_OUT
    connected to existing zones via tracks
    - R15/R16 (I2C SDA/SCL series 100R) inserted between J1 and U1
    with existing I2C traces ripped up and rerouted
    DRC: 0 violations, parity clean.
    [cupwarmer-hw.kicad_pcb]
2026-05-18 Add fab outputs and ignore zip archives
    Commit gerbers, JLCPCB BOM, and CPL placement file for the cupwarmer-hw
    board; ignore *.zip so packaged fab bundles stay out of git.
    [cupwarmer-hw-B_Cu.gbl, cupwarmer-hw-B_Mask.gbs, cupwarmer-hw-B_Paste.gbp, cupwarmer-hw-B_Silkscreen.gbo, cupwarmer-hw-Edge_Cuts.gm1, cupwarmer-hw-F_Cu.gtl, cupwarmer-hw-F_Mask.gts, cupwarmer-hw-F_Paste.gtp]
2026-05-23 Update cupwarmer PCB fab outputs
    [cupwarmer-hw-B_Cu.gbl, cupwarmer-hw-B_Mask.gbs, cupwarmer-hw-B_Paste.gbp, cupwarmer-hw-B_Silkscreen.gbo, cupwarmer-hw-Edge_Cuts.gm1, cupwarmer-hw-F_Cu.gtl, cupwarmer-hw-F_Mask.gts, cupwarmer-hw-F_Paste.gtp]
2026-05-23 Sync PCB footprint properties
    [cupwarmer-hw.kicad_pcb]
2026-05-24 Remove PCB mounting holes
    [cupwarmer-hw.kicad_pcb, cupwarmer-hw.kicad_sch]
2026-05-24 Add enclosure prototype mechanical model
    [enclosure-proto.scad]
2026-05-24 Switch enclosure to one-piece tray with integrated lip
    Drop the separate top retaining ring in favor of a bottom tray with an
    integrated low retaining lip, route the heater cable internally to the
    PCB instead of through a side channel, and model F1 (KSD9700 C156512)
    on the heater bottom side with a 5.6 mm clearance gap. Replace the
    annular PCB ledge with six wall ribs and add four taller stack
    retention ribs that pass through PCB/insulation edge notches.
    [enclosure-proto.scad]
2026-05-24 Merge mechanical BOM into unified bom.csv
    Rename initial-bom.csv to bom.csv and add MECH-* rows for heater
    assembly, aluminum spreader, cup contact pad, PCB-heater insulation,
    one-piece enclosure tray, silicone foot/ring, and perimeter adhesive.
    JLCPCB/Seeed Fusion order BOMs will be extracted from this file at
    order time, filtering on status and lcsc presence.
    [bom.csv]
2026-05-24 Align enclosure ribs with PCB edge notches
    Add four edge notches to the PCB outline at 30/120/210/300 deg for the
    stack-retention ribs to pass through. Reposition the SCAD ribs to match:
    stack retention to 30/120/210/300 deg, PCB support ribs reduced to 4 and
    moved to 60/150/240/330 deg so the two rib families interleave with 30
    deg separation.
    [cupwarmer-hw.kicad_pcb, enclosure-proto.scad]
2026-05-24 Reduce I2C testpads to single TP1
    Remove the duplicate testpad and rename the remaining one to TP1.
    [heater-control.kicad_sch]
2026-05-24 Note LED viewing window as open mechanical item
2026-05-24 Add M2 plastic-screw bosses on PCB support ribs
    Add a cylindrical M2 self-tap boss (φ5, pilot φ1.7, 4mm deep) on top of
    each of the 4 PCB support ribs in the enclosure, hulled with the rib for
    a smooth tangent blend and inset 0.5mm outward from the rib inner face
    so the boss does not protrude into the L1 coil envelope.
    Add 2 NPTH φ2.4 mounting holes (H1, H2) on the PCB that match the boss
    positions. Rename the existing heater-harness footprint H1→J2 to free
    up the H prefix for the new mounting holes, and rename the off-board
    heater-side connector H2→J3 in the schematic for consistency.
    [cupwarmer-hw.kicad_pcb, enclosure-proto.scad, heater-control.kicad_sch]
2026-05-24 Fix DRC: link mounting holes to schematic and custom footprint
    Add Mechanical:MountingHole symbols H1/H2 to the top-level schematic so
    the PCB mounting holes are no longer flagged as extra_footprint by DRC.
    Add a custom cupwarmer:MountingHole_M2_Plastic_D2.4mm footprint to the
    project library and point both PCB footprints at it so the lib copy
    matches the in-board geometry. Align Value and Description fields
    between schematic and PCB.
    [cupwarmer-hw.kicad_pcb, cupwarmer-hw.kicad_sch]
2026-05-24 Reposition mounting hole symbols and save KiCad UI state
    [cupwarmer-hw.kicad_pcb, cupwarmer-hw.kicad_sch]
2026-05-25 Update PCBA BOM and fabrication outputs
    [bom.csv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]
2026-05-31 Add DFM trace spacing DRC warnings
2026-05-31 Update PCB spacing DRC coverage
    [cupwarmer-hw.kicad_pcb]
2026-05-31 Add through-hole to SMD spacing rule
    [cupwarmer-hw.kicad_pcb]
2026-05-31 Update silkscreen DRC rules
    [cupwarmer-hw.kicad_pcb]
2026-05-31 Add silkscreen to hole DRC rule
2026-05-31 Update PCB layout
    [cupwarmer-hw.kicad_pcb]
2026-05-31 Swap C11/C13/C18/C19 to Murata GRM1885C1H103JA01D; regen fab outputs
    YAGEO CC0603JRNPO9BN103 (C389113) is low-stock on JLCPCB (~1.2k, Extended).
    Swap the four 10nF/50V C0G caps to Murata GRM1885C1H103JA01D (C85973,
    in-stock) in rx-power.kicad_sch and both BOMs. Same value/footprint/
    dielectric/tolerance — electrically equivalent drop-in.
    Also regenerate gerbers, drill files, and the JLCPCB CPL from the current
    PCB.
    [bom.csv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]
2026-06-02 Fix reversed TVS polarity (Z1/Z3/Z4) and convert TVS to zener symbols
    Z1-Z4 are unidirectional TVS (SMF13A/SMF13A/SMBJ15A/SMBJ18A) that were
    drawn with a generic non-polarized symbol (cupwarmer:PASSIVE_2), hiding a
    polarity error: Z1, Z3, Z4 had cathode->GND, anode->positive node (would
    forward-conduct and effectively short AC1/VOUT_12V/VRECT). Only Z2 was
    correct.
    - Re-type Z1-Z4 to Device:D_Zener so polarity is visible; add 1.27mm
    collinear stub wires to bridge the D_Zener pin-tip pitch (3.81 vs
    PASSIVE_2's 5.08mm). Embedded lib_symbols updated.
    - Rotate Z1/Z3/Z4 180 deg so cathode (pin1/K) faces the protected node:
    Z1->AC1, Z2->AC2, Z3->VOUT_12V, Z4->VRECT; anode->SYS_GND for all.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
    [cupwarmer-hw.kicad_pcb, rx-power.kicad_sch]
2026-06-06 Fix TVS footprint parity
    [cupwarmer-hw.kicad_pcb, rx-power.kicad_sch]
2026-06-06 Align C18/C19 & R3 parts, reconcile BOM/CPL with PCB, regen fab
    - C18/C19: YAGEO NP0 CC0603JRNPO9BN103 (C389113) -> Murata C0G
    GRM1885C1H103JA01D (C85973), unifying with C11/C13 (sch/pcb/bom)
    - R3: default to 0.05R 1W FRM121WFR050TM (C7467249) bring-up shunt;
    0R 1206 jumper kept as production alternate (sch/pcb)
    - Z1/Z3/Z4 TVS rotation/polarity reflected in PCB + CPL; gerbers regenerated
    - BOM: rename heater-harness ref H1 -> J2 to match PCB; merge C11/C13 into
    one row; note J1 as hand-soldered THT excluded from CPL
    - CPL: drop non-assembled parts (J1, J2, L1) and fiducials (FID1-3);
    45 SMT placements remain
    - Verified BOM <-> jlcpcb-bom <-> CPL <-> PCB parity: designators, LCSC,
    a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
    [bom.csv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]
2026-06-06 Tighten trace-spacing DRC to reject exactly-0.09mm; polarity/CPL fixes
    DRC rule (.kicad_dru):
    - Bump trace-spacing clearance from 0.09mm to 0.091mm on the
    outer/inner JLCPCB rules and the U1 BGA escape rule. KiCad quantizes
    rule clearance to 1um, so 0.091mm is the smallest value that rejects a
    zero-margin 0.09mm gap (the JLC 4-layer limit). This now flags the U1
    BGA fanout traces routed exactly at the limit.
    Polarity / fab parity (pre-existing working-tree changes):
    - Normalize diode Description fields (Schottky/Zener/LED) and symbol
    values across heater-control / rx-power sheets.
    - Add design-note on JLC CPL rotation risk for polarized parts.
    - Move CPL output under hardware/fab/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
    [cupwarmer-hw.kicad_pcb, heater-control.kicad_sch, rx-power.kicad_sch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]
2026-06-06 Regenerate fab gerbers/drill for re-routed board
    - Re-export Gerber (X2) + Excellon drill from current PCB; previous
    outputs predated the trace-spacing re-route in f8f007d and were stale
    - CPL re-exported, unchanged (45 placements, geometry identical)
    [cupwarmer-hw-B_Cu.gbl, cupwarmer-hw-B_Mask.gbs, cupwarmer-hw-B_Paste.gbp, cupwarmer-hw-B_Silkscreen.gbo, cupwarmer-hw-Edge_Cuts.gm1, cupwarmer-hw-F_Cu.gtl, cupwarmer-hw-F_Mask.gts, cupwarmer-hw-F_Paste.gtp]
2026-06-06 enclosure-proto: order Visibility toggles top-to-bottom; echo overall height
    Reorder the Visibility customizer toggles to match the physical stack from
    top (cup contact pad) to bottom (tray). Add an echo of the overall external
    height (tray floor to pad top = 8.25 mm).
    [enclosure-proto.scad]
2026-06-06 Shift lower-half components upward on PCB
    [cupwarmer-hw.kicad_pcb]
2026-06-06 Resize PCB to 50mm circular outline, drop locating notches
    [cupwarmer-hw.kicad_pcb]
2026-06-06 Pull edge-crossing parts inward for 50mm outline clearance
    Move J1, H1, H2, L1, J2, D1, D2, FID1-3 radially inward so all pads
    clear the new 25mm-radius edge by ~1mm. DRC clean.
    [cupwarmer-hw.kicad_pcb]
2026-06-06 Split retaining lip into separate top_retaining_ring part
    The single-piece tray's integrated lip overhung the cup contact pad edge
    (inner Ø55.6 < pad Ø56.5), an assembly undercut: a rigid pad cannot pass
    under the lip from the top. Splitting the lip into a separate printed part
    removes the undercut -- all parts incl. the pad drop straight into the open
    tray, then the ring is fitted on top and its flange captures the pad edge.
    - New show_top_retaining_ring visibility toggle (topmost in stack order)
    - bottom_tray() loses the integrated lip, drip-break ledge and spreader
    pocket shelves; upper bore opens to pad_clear_od (Ø57.2) and runs straight
    from the heater seat to the rim (no inward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
    [enclosure-proto.scad]
2026-06-06 DRC clean after 50mm resize: reconnect nets, relocate parts, add U1 same-net via escape rule
    - Reconnect RX_VAA/I2C_SDA/I2C_SCL tracks to moved J1 pads; drop dangling stubs
    - Move SYS_GND via inward to clear board edge; shift R10/R11 to clear D1/D2 courtyards
    - Restagger J1 (VAA/GND/SDA/SCL) and VOUT/HTR_OUT silk to clear edge/holes
    - Add "U1 BGA Escape Via Hole to Via Hole (Same Net)" .dru rule (min 0.2mm)
    so dense same-net SYS_GND stitching vias under U1 pass; rest of board stays 0.254mm
    - Result: 0 DRC violations, 0 unconnected
    [cupwarmer-hw.kicad_pcb]
2026-06-06 Remove stale kicad-tool schematic-parity TODO plan
    Tracked in kicad-skills repo, not cupwarmer.
2026-06-06 Align PCB support ribs to 50mm PCB H1/H2 hole positions
    H1=(121,92), H2=(79,108) relative to board center (100,100) →
    pcb_support_holes [21,-8]/[-21,8], replacing stale 56mm values.
    [enclosure-proto.scad]
2026-06-13 Resize flexible heater to Ø55 and fix size/resistance docs
    Heater outline was Ø56 "to match the control PCB", but the control PCB
    was resized to Ø50. Re-base the heater on the thermal stack instead:
    Ø55 covers the aluminum spreader (Ø54.5), seats on the bottom-tray
    heater-seat step (Ø50.7/Ø57.2), and stays under the cup contact pad
    (Ø56.5). Reconcile the heater resistance to 12Ω (12V/1A/12W) across all
    docs; the Open Items "15Ω provisional" note contradicted §3, the heater
    README, and the R3/Q1 continuous-1A assumptions.
    - generate_heater.py: OUTLINE_RADIUS 28.0 -> 27.5; drop "matches PCB"
    rationale in board comment and README, regenerate PCB/README/gerbers/zip
    - design-notes.m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
    [heater.kicad_pcb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]
2026-06-13 Regenerate fab outputs after D1/D2 silkscreen and zone refill
    Reposition D1/D2 reference labels and refresh the front copper zone fill,
    then regenerate gerbers, drill files, and the JLCPCB CPL to match.
    [cupwarmer-hw-B_Cu.gbl, cupwarmer-hw-B_Mask.gbs, cupwarmer-hw-B_Paste.gbp, cupwarmer-hw-B_Silkscreen.gbo, cupwarmer-hw-Edge_Cuts.gm1, cupwarmer-hw-F_Cu.gtl, cupwarmer-hw-F_Mask.gts, cupwarmer-hw-F_Paste.gtp]
2026-06-13 Move heater leadout pads inward and regen gerbers
    J1 leadout footprint moved Y122.5 -> 121.7 (0.8mm toward center).
    Regenerate gerbers/zip from the hand-edited PCB and sync the leadout
    position in generate_heater.py so a future regen keeps the move.
    [heater.kicad_pcb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]
2026-06-13 Move heater gerbers to hardware/fab/heater to unify fab layout
    Match the cupwarmer-hw convention: fab outputs under hardware/fab/<board>/
    with individual gerbers in gerbers/ and the upload zip at the parent.
    Heater gerbers move from hardware/kicad/heater/gerber/ to
    hardware/fab/heater/{gerbers/,heater-jlcpcb-flex-heater.zip}. Update the
    upload-path reference in README and generate_heater.py.
    [heater-Edge_Cuts.gm1, heater-F_Cu.gtl, heater-F_Mask.gts, heater-F_Silkscreen.gto, heater-User_Comments.gbr]
2026-06-13 Consolidate hardware docs into design-notes
    Remove scattered hardware/ markdown that duplicated design-notes or
    restated state now owned by the KiCad sources:
    - Delete hardware/schematic/README.md and hardware/pcb/README.md: the
    why/rationale lives in design-notes, and current net names, footprints,
    stackup, and placement are sourced from .kicad_sch/.kicad_pcb.
    - Delete hardware/pcb/floorplan-v1.md and
    hardware/schematic/stwlc38jrm-initial-netlist.md (superseded drafts).
    - Delete hardware/kicad/cupwarmer-hw/README.md and
    hardware/kicad/heater/README.md; fold the flexible-heater fab spec and
    JLCPCB order notes into design-notes under 発熱体・熱設計.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
2026-06-13 Add cupwarmer-fab-outputs skill (JLCPCB BOM + CPL generator)
    Headless, deterministic regeneration of the cupwarmer-hw JLCPCB BOM and
    CPL from KiCad via kicad-cli plus a transform:
    - BOM is constrained to the CPL part set (BOM subset of CPL): only
    pick-and-placed SMD parts that carry an LCSC # appear in either file.
    THT/hand-mount/external parts (J1, F1, L1, J2/J3, R_HTR1, TH2) are
    excluded from both and reported.
    - Footprint hint preserved from the existing BOM by LCSC #; CPL written
    CRLF to match the repo convention (reproduces the committed CPL byte
    for byte). Warns on placed parts missing an LCSC #.
    - Heater is out of scope (flex heater has no assembled SMT parts).
    Co-Authored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
2026-06-13 Restore D1/D2 LED part numbers and regen JLCPCB BOM
    D1/D2 indicator LEDs had lost their MPN/LCSC in rx-power.kicad_sch,
    dropping them from the assembly BOM. Restore the parts and regenerate
    hardware/bom/jlcpcb-bom.csv with the new generator:
    - D1: XL-1608SURC-04 (C965798), D2: XL-1608UGC-04 (C965804)
    - BOM regenerated; J1 (THT, not pick-and-placed) now excluded so the
    BOM matches the CPL part set. CPL unchanged.
    [jlcpcb-bom.csv, rx-power.kicad_sch]
2026-06-16 Switch F1 thermal cutoff to leaded KSD9700-70 (C156512)
    JLCPCB cannot assemble the SMD thermal cutoffs on its flexible-heater
    line: NR72CB0 (C183007) and SA77SB0 (C143808) both require laser welding
    and their datasheets forbid soldering. Revert F1 to the original
    wire-solderable leaded bimetal thermostat KSD9700-70/5JSB/080C (C156512)
    — the lowest-profile hand-solderable 70C resettable part JLC stocks
    (trip 70+/-5C, reset 50+/-10C, AC250V/5A, DC12V/12A).
    - heater-control.kicad_sch: F1 Value/MPN/LCSC/Manufacturer/Description
    - bom.csv: F1 row + MECH-HEATER1 heater-assembly note
    - design-notes.md: part spec, rationale, mechanical-clearance caveat, Open Items
    - mechanical/README.md: glossary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
    [bom.csv, enclosure-proto.scad, heater-control.kicad_sch]
2026-07-26 Record v1 procurement actuals, JLC heater review, and first bring-up
    The off-board procurement checklist was still all-TODO while every v1 part
    had in fact been ordered and received. Replace it with actuals and capture
    what was learned outside the repo (JLCPCB email threads, first power-on).
    - Off-board checklist -> "v1 手配実績": real order numbers, ship dates and
    arrival status for the control PCB + SMT, U1, flex heater, F1, TH2, L1,
    SHIELD1, and the Qi TX pad. List what is genuinely still unordered.
    - Note that U1 (STWLC38JRM) is not JLC-stocked, so future runs must do the
    parts pre-order -> Private Inventory "Complete" -> PCBA sequence.
    - Flag that heater, F1 and TH2 exist in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
2026-07-26 Trim CLAUDE.md to conventions that hold in practice
    The scratch-file rules had drifted from reality: tmp/ holds 400+ files with
    exactly the proliferating names the old "Reuse files instead of fanning out"
    section forbade (A_drc.rpt, B_erc.json, baseline-c1-split, before-led.png).
    Replace that section with the policy actually worth enforcing — tmp/ is
    disposable, don't assume a file survives across sessions, don't cite one as
    evidence, keep anything durable in docs/ or wiki/.
    - Add "nothing generated lands at the repo root". A stray
    cupwarmer-test-drc.rpt had accumulated there; deleted (untracked, ignored,
    0 violations against the old cupwarmer-test board).
    - Drop the Task management s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
2026-07-26 Document NVM prerequisites and correct the GPIO0 default
    Asking "what actually breaks without NVM" surfaced that the repo had the
    GPIO0 power-on default wrong, and that nothing captured how much of the
    design depends on config that cannot be written over I2C at runtime.
    - Add a "NVM 書込み前提" section: what works without NVM (rectifier, POVP,
    HOVP, TSHUT, UVLO, the NTC hard comparator) versus what is CFG-only and
    therefore dead until NVM is written (EPP VOUT, NTC protection actions,
    FOD coefficients, GPIO0 Func, threshold set, EPP negotiation).
    - Call out the safety consequence: the B-only fail-safe assumes STWLC38
    cuts VOUT when the NTC divider trips at 70C, but that action i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
2026-07-26 Make enclosure reference parts opaque
    [enclosure-proto.scad]
2026-07-26 Update enclosure for direct TP-4 pad trial
    [enclosure-proto.scad]
2026-07-26 Avoid enclosure collision with RX coil
    [enclosure-proto.scad]
2026-07-26 Add side support shelves around RX coil
    [enclosure-proto.scad]
2026-07-26 Match enclosure PCB thickness to JLC order
    [enclosure-proto.scad]
2026-07-26 Update tray stack for ordered heater assembly
    [enclosure-proto.scad]
2026-07-26 Clean up direct-pad enclosure model
    [enclosure-proto.scad]
2026-07-26 Add printable tray edge chamfers
    [enclosure-proto.scad, enclosure-proto.stl]
2026-07-26 Record DMM tray print order
2026-09-23 docs: add STWLC38 NVM wiring layout diagram
2026-10-12 fix: correct STWLC38 NTC threshold encoding for prototype
